lexx-polarnet-pl/planck6502/Mechanical/README.md

## Planck/Lexx W65C02 Computer – Mechanical Parts

This folder contains 3D models and printable components designed for assembling the Planck/Lexx W65C02 computer.
