lexx-polarnet-pl/planck6502/Hardware/joystick_board/README.md

## Planck 6502 Joystick Interface

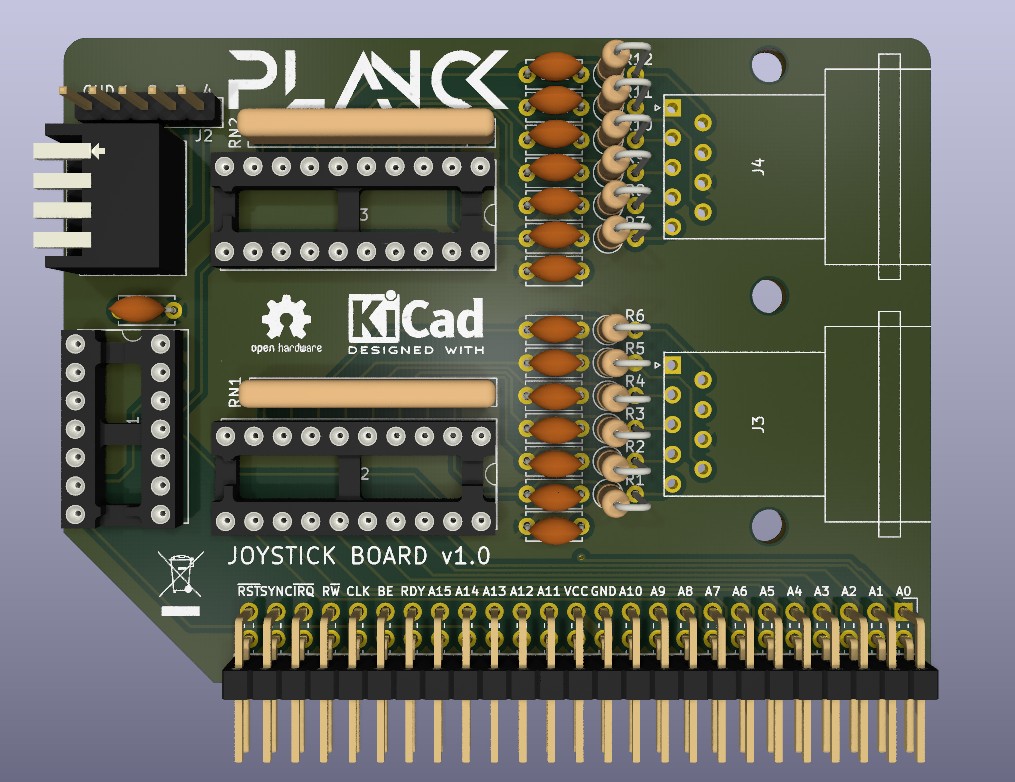
[picture p3: Hardware/joystick_board/pictures/joystick_prototype_render.jpg]
Joystick Board prototype 3D render


This is the dual joystick interface card for the Planck 6502 computer.

This is an entirely new build, not based on any existing board from the original Planck project.

## Revision History

| Version | Status | Changes |
| :---: | :---: | :--- |
| **1.0** | Under construction | Initial design |

**This board is a work in progress.**

This card aims to be a simple interface between joysticks and the 6502 CPU. The design supports standard Atari DB9 joysticks, extended to support dual fire buttons. The card also features built-in ESD protection.
