lexx-polarnet-pl/planck6502/Hardware/keyboard_mouse_board/1.1/board.png

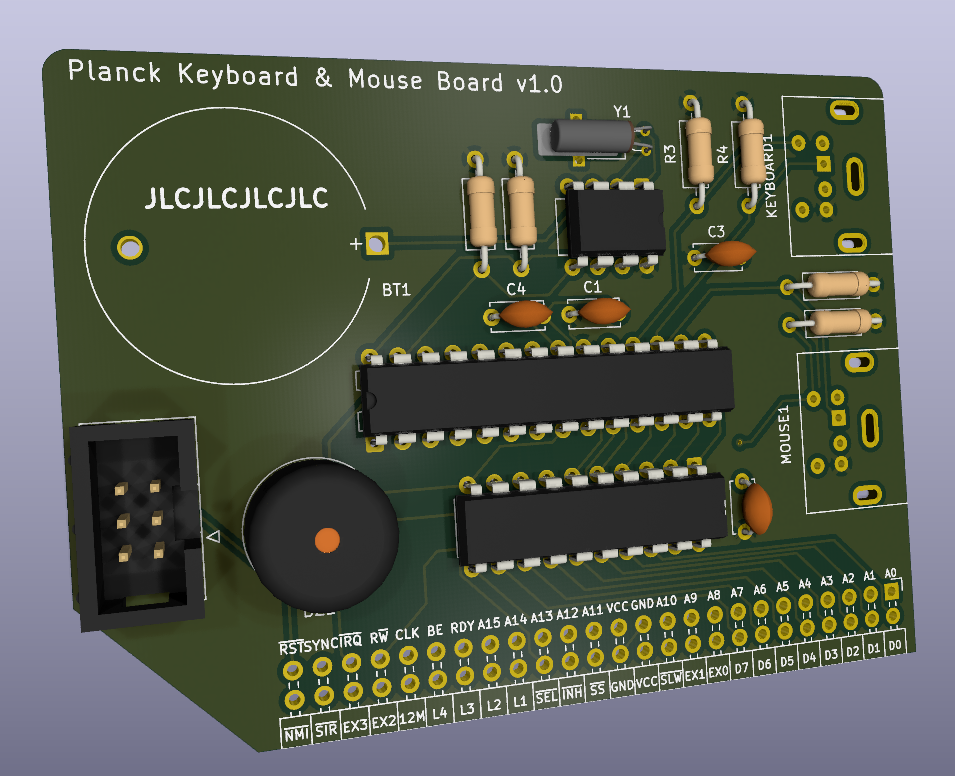
Hardware/keyboard_mouse_board/1.1/board.png
