lexx-polarnet-pl/planck6502/Hardware/keyboard_mouse_board/pictures/keyboard_mouse_board_1.0_back.jpg

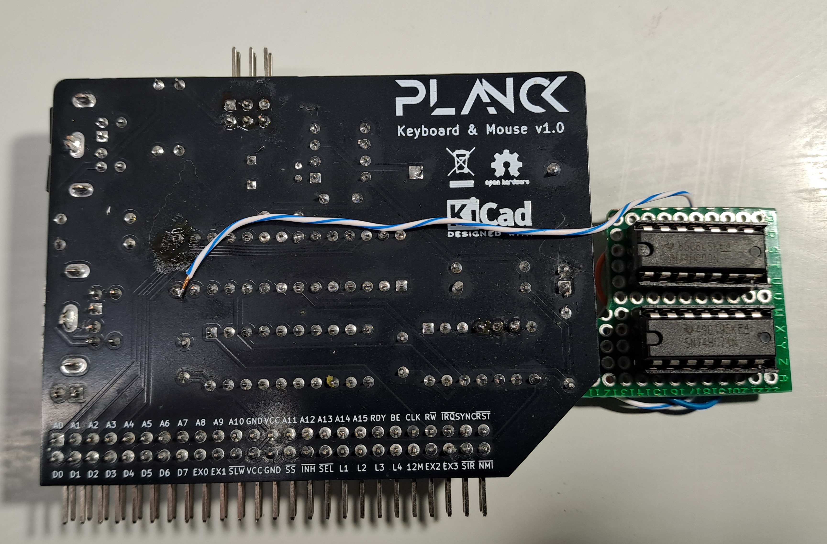
Hardware/keyboard_mouse_board/pictures/keyboard_mouse_board_1.0_back.jpg
