lexx-polarnet-pl/planck6502/Hardware/mainboard/3D/barrel_jack.step

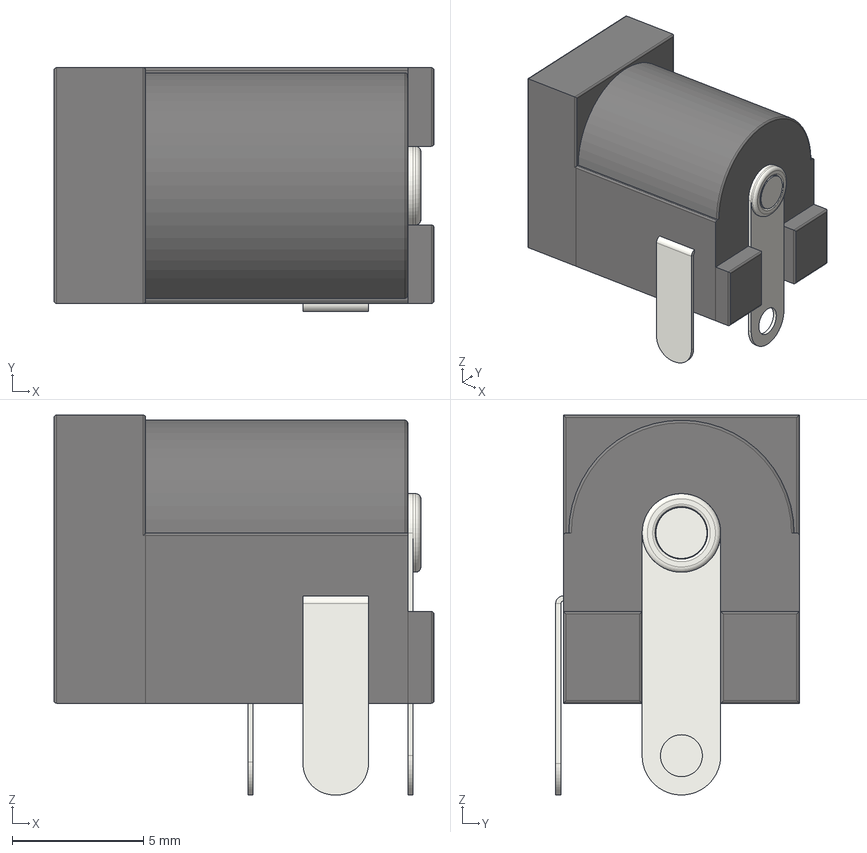
[picture p12: CAD file, 2026-10-25]
Hardware/mainboard/3D/barrel_jack.step
14.5 x 9.30 x 14.5 mm
