lexx-polarnet-pl/planck6502/Mechanical/planck_joystick_port_bracket.stl

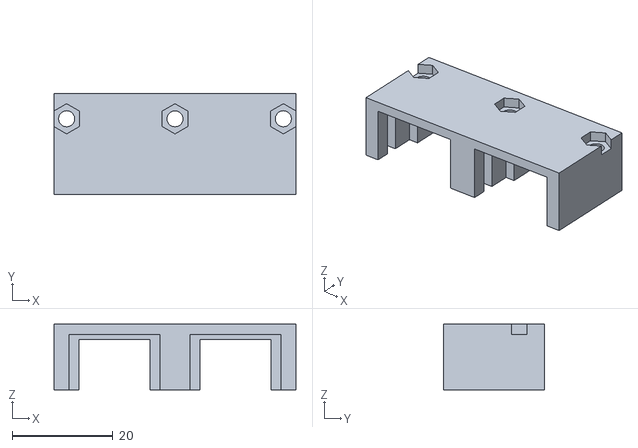
[picture p13: CAD file, 2026-11-07]
Mechanical/planck_joystick_port_bracket.stl
48.0 x 20.0 x 13.0
