lexx-polarnet-pl/planck6502/Mechanical/cards_separator.stl

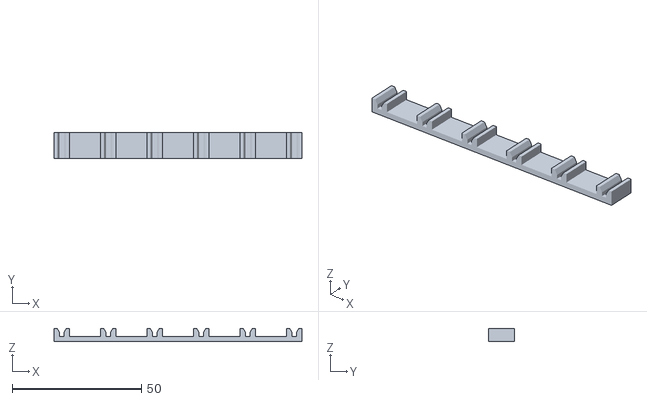
[picture p14: CAD file, 2026-10-25]
Mechanical/cards_separator.stl
96.0 x 10.0 x 5.00
