lexx-polarnet-pl/planck6502/Hardware/joystick_board/joystick.kicad_pcb

## KiCad design Hardware/joystick_board/joystick.kicad_pcb (2026-11-11)

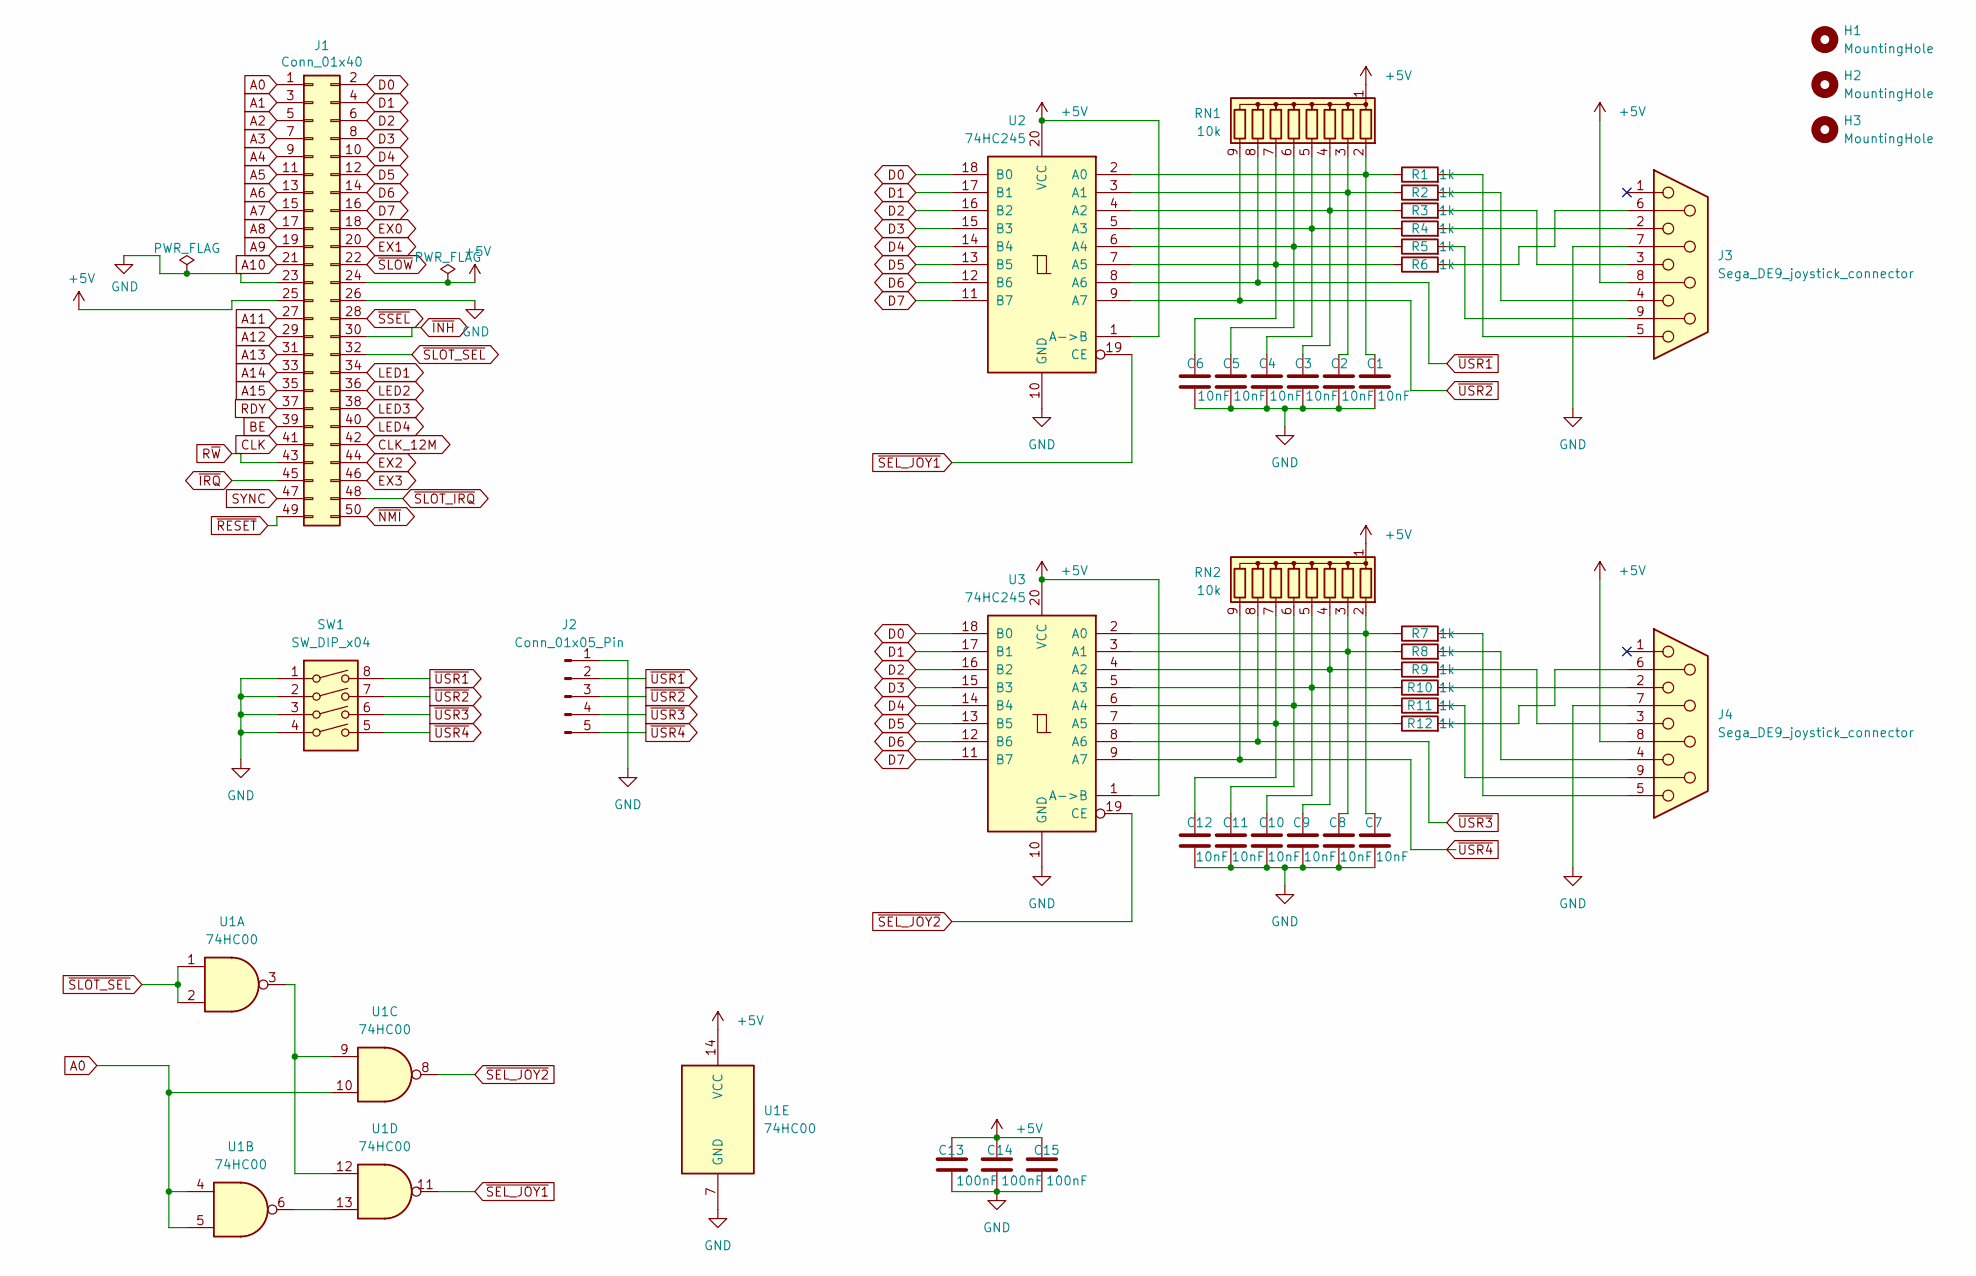
[picture p15: schematic joystick.kicad_sch, Planck joystick board]

Parts:
C1, C2, C3, C4, C5, C6, C7, C8, C9, C10, C11, C12: 10nF; C_Disc_D5.0mm_W2.5mm_P5.00mm
C13, C14, C15: 100nF; C_Disc_D5.0mm_W2.5mm_P5.00mm
H1, H2, H3: MountingHole; MountingHole_3.2mm_M3
J1: Conn_01x40; PinHeader_2x25_P2.54mm_Horizontal
J2: Conn_01x05_Pin; PinHeader_1x05_P2.54mm_Vertical
J3, J4: Sega_DE9_joystick_connector; Sega DE9 joystick connector
R1, R2, R3, R4, R5, R6, R7, R8, R9, R10, R11, R12: 1k; R_Axial_DIN0207_L6.3mm_D2.5mm_P2.54mm_Vertical
RN1, RN2: 10k; R_Array_SIP9
SW1: SW_DIP_x04; SW_DIP_SPSTx04_Piano_CTS_Series194-4MSTN_W7.62mm_P2.54mm
U1: 74HC00; DIP-14_W7.62mm_Socket
U2, U3: 74HC245; DIP-20_W7.62mm_Socket

Connections:
+5V: C13.1, C14.1, C15.1, J1.24, J1.25, J3.8, J4.8, RN1.1 (common), RN2.1 (common), U1.14 (VCC), U2.1 (A->B), U2.20 (VCC), U3.1 (A->B), U3.20 (VCC)
A0: J1.1, U1.4, U1.5, U1.10
A1: J1.3
A2: J1.5
A3: J1.7
A4: J1.9
A5: J1.11
A6: J1.13
A7: J1.15
A8: J1.17
A9: J1.19
A10: J1.21
A11: J1.27
A12: J1.29
A13: J1.31
A14: J1.33
A15: J1.35
BE: J1.39
CLK: J1.41
CLK_12M: J1.42
D0: J1.2, U2.18 (B0), U3.18 (B0)
D1: J1.4, U2.17 (B1), U3.17 (B1)
D2: J1.6, U2.16 (B2), U3.16 (B2)
D3: J1.8, U2.15 (B3), U3.15 (B3)
D4: J1.10, U2.14 (B4), U3.14 (B4)
D5: J1.12, U2.13 (B5), U3.13 (B5)
D6: J1.14, U2.12 (B6), U3.12 (B6)
D7: J1.16, U2.11 (B7), U3.11 (B7)
EX0: J1.18
EX1: J1.20
EX2: J1.44
EX3: J1.46
GND: C1.2, C2.2, C3.2, C4.2, C5.2, C6.2, C7.2, C8.2, C9.2, C10.2, C11.2, C12.2, C13.2, C14.2, C15.2, J1.23, J1.26, J2.1, J3.7, J4.7, SW1.1, SW1.2, SW1.3, SW1.4, U1.7 (GND), U2.10 (GND), U3.10 (GND)
LED1: J1.34
LED2: J1.36
LED3: J1.38
LED4: J1.40
unnamed: J3.2, R4.2
unnamed: J3.3, R3.2
unnamed: J3.4, R2.2
unnamed: J3.5, R1.2
unnamed: J3.6, R6.2
unnamed: J3.9, R5.2
unnamed: J4.2, R10.2
unnamed: J4.3, R9.2
unnamed: J4.4, R8.2
unnamed: J4.5, R7.2
unnamed: J4.6, R12.2
unnamed: J4.9, R11.2
unnamed: C1.1, R1.1, RN1.2 (R1), U2.2 (A0)
unnamed: C2.1, R2.1, RN1.3 (R2), U2.3 (A1)
unnamed: C3.1, R3.1, RN1.4 (R3), U2.4 (A2)
unnamed: C4.1, R4.1, RN1.5 (R4), U2.5 (A3)
unnamed: C5.1, R5.1, RN1.6 (R5), U2.6 (A4)
unnamed: C6.1, R6.1, RN1.7 (R6), U2.7 (A5)
unnamed: C7.1, R7.1, RN2.2 (R1), U3.2 (A0)
unnamed: C8.1, R8.1, RN2.3 (R2), U3.3 (A1)
unnamed: C9.1, R9.1, RN2.4 (R3), U3.4 (A2)
unnamed: C10.1, R10.1, RN2.5 (R4), U3.5 (A3)
unnamed: C11.1, R11.1, RN2.6 (R5), U3.6 (A4)
unnamed: C12.1, R12.1, RN2.7 (R6), U3.7 (A5)
unnamed: U1.3, U1.9, U1.12
unnamed: U1.6, U1.13
RDY: J1.37
R~W: J1.43
SYNC: J1.47
~INH: J1.30
~IRQ: J1.45
~NMI: J1.50
~RESET: J1.49
~SEL_JOY1: U1.11, U2.19 (CE)
~SEL_JOY2: U1.8, U3.19 (CE)
~SLOT_IRQ: J1.48
~SLOT_SEL: J1.32, U1.1, U1.2
~SLOW: J1.22
~SSEL: J1.28
~USR1: J2.2, RN1.8 (R7), SW1.8, U2.8 (A6)
~USR2: J2.3, RN1.9 (R8), SW1.7, U2.9 (A7)
~USR3: J2.4, RN2.8 (R7), SW1.6, U3.8 (A6)
~USR4: J2.5, RN2.9 (R8), SW1.5, U3.9 (A7)

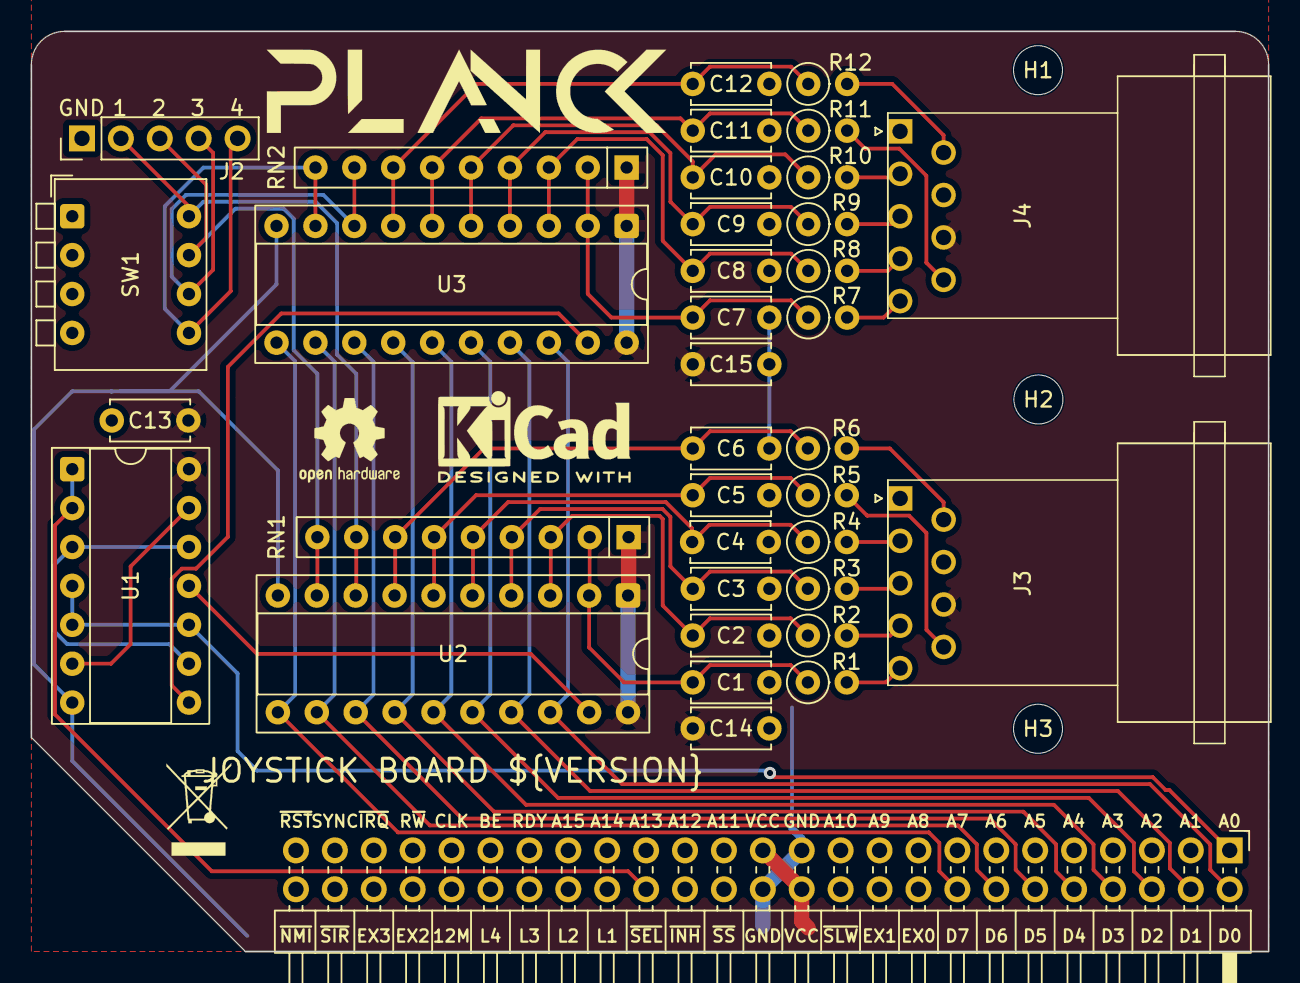
[picture p16: board joystick.kicad_pcb from above]

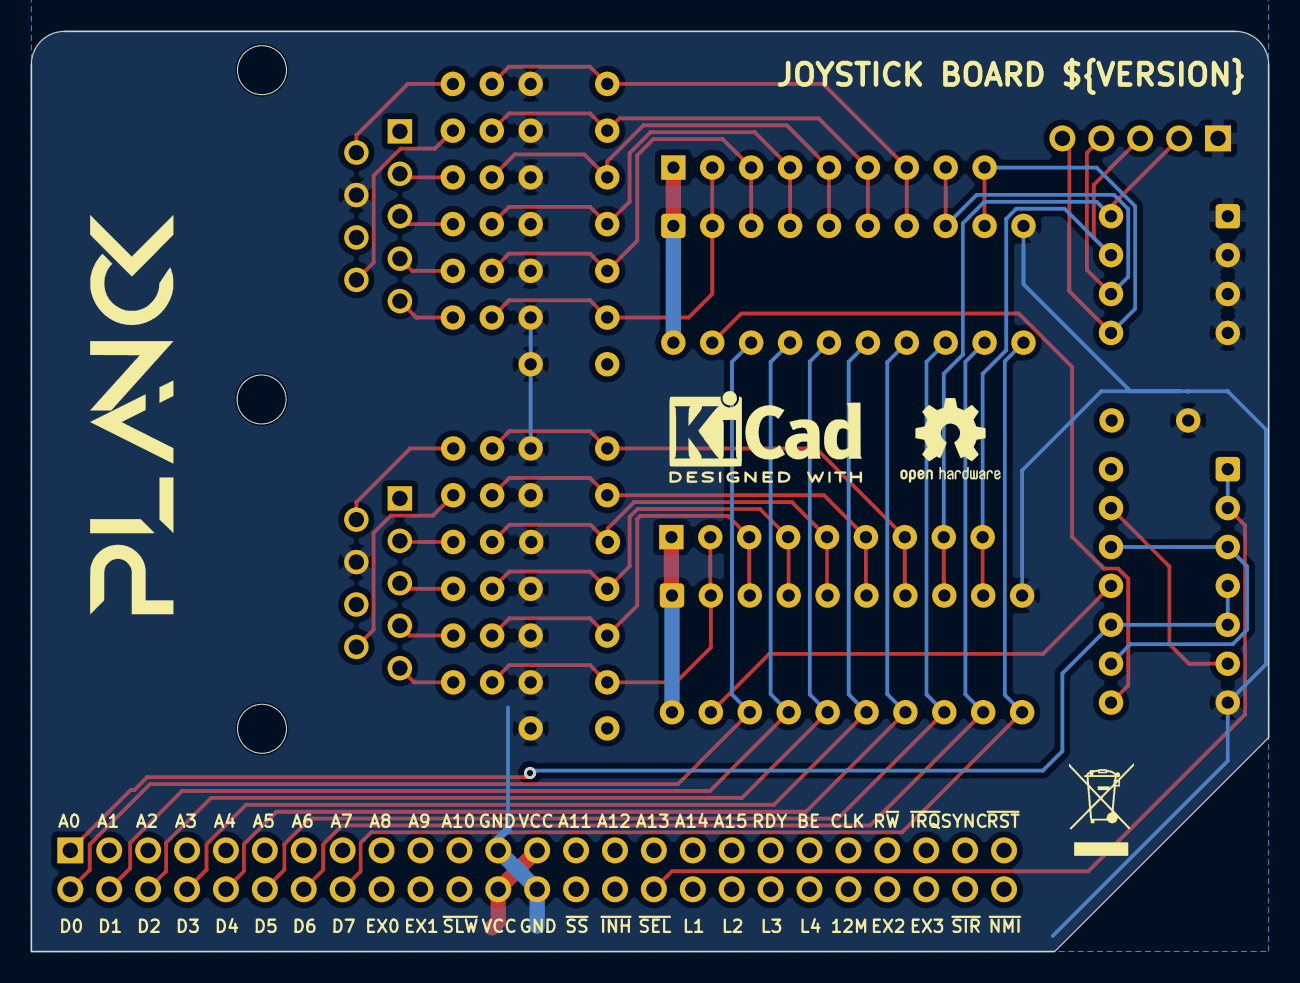
[picture p17: board joystick.kicad_pcb from below]

Board: 2 copper layers, 80.8 x 60.1 mm, 48 parts (4 on the bottom side), 44 nets.

Other parts of the board:
KICADLOGO1, KICADLOGO2: KiCad-Logo2_5mm_SilkScreen
LOGO1, LOGO2: LOGO; logo
OPENHARDWARE1, OPENHARDWARE2: OSHW-Logo2_7.3x6mm_SilkScreen
WASTE1, WASTE2: WEEE-Logo_4.2x6mm_SilkScreen
