lexx-polarnet-pl/planck6502/Hardware/pico_vga2/pico2_vga.kicad_pcb

## KiCad design Hardware/pico_vga2/pico2_vga.kicad_pcb (2026-11-11)

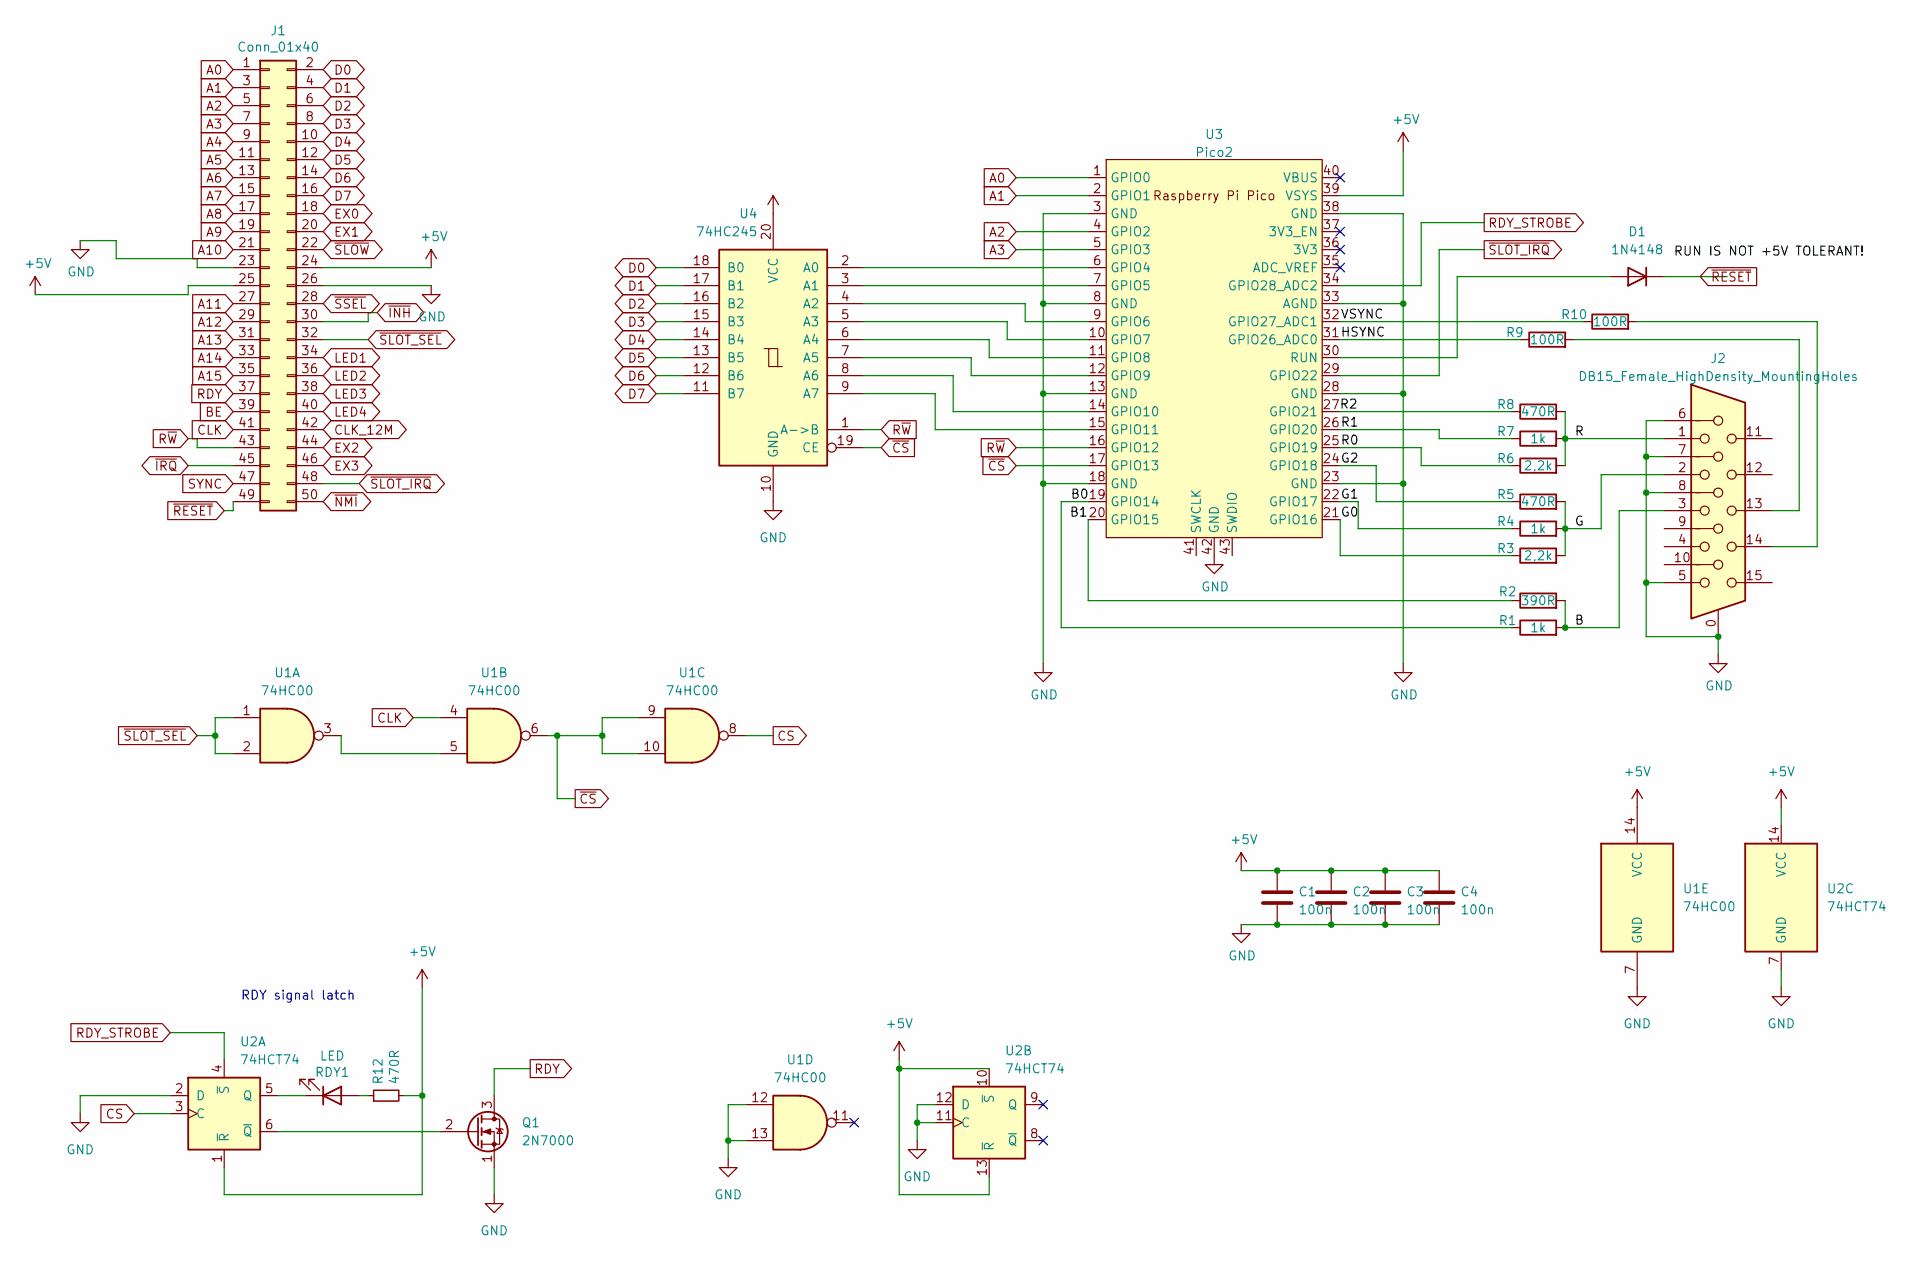
[picture p18: schematic pico2_vga.kicad_sch, Pico2 VGA board]

Parts:
C1, C2, C3, C4: 100n; C_Disc_D5.0mm_W2.5mm_P5.00mm
D1: 1N4148; D_DO-35_SOD27_P7.62mm_Horizontal
J1: Conn_01x40; PinHeader_2x25_P2.54mm_Horizontal
J2: DB15_Female_HighDensity_MountingHoles; DSUB-15-HD_Socket_Horizontal_P2.29x1.90mm_EdgePinOffset3.03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
Q1: 2N7000; TO-92_Inline
R1, R4, R7: 1k; R_Axial_DIN0309_L9.0mm_D3.2mm_P2.54mm_Vertical
R2: 390R; R_Axial_DIN0309_L9.0mm_D3.2mm_P2.54mm_Vertical
R3, R6: 2,2k; R_Axial_DIN0309_L9.0mm_D3.2mm_P2.54mm_Vertical
R5, R8: 470R; R_Axial_DIN0309_L9.0mm_D3.2mm_P2.54mm_Vertical
R9, R10: 100R; R_Axial_DIN0309_L9.0mm_D3.2mm_P2.54mm_Vertical
R12: 470R; R_Axial_DIN0207_L6.3mm_D2.5mm_P10.16mm_Horizontal
RDY1: LED; LED_D3.0mm
U1: 74HC00; DIP-14_W7.62mm_Socket
U2: 74HCT74; DIP-14_W7.62mm_Socket
U3: Pico2; RPi_Pico_SMD_TH
U4: 74HC245; DIP-20_W7.62mm_Socket

Connections:
+5V: C1.1, C2.1, C3.1, C4.1, J1.24, J1.25, R12.2, U1.14 (VCC), U2.1 (~R), U2.10 (~S), U2.13 (~R), U2.14 (VCC), U3.39 (VSYS), U4.20 (VCC)
/B: J2.3, R1.2, R2.2
/B0: R1.1, U3.19 (GPIO14)
/B1: R2.1, U3.20 (GPIO15)
/G: J2.2, R3.2, R4.2, R5.2
/G0: R3.1, U3.21 (GPIO16)
/G1: R4.1, U3.22 (GPIO17)
/G2: R5.1, U3.24 (GPIO18)
/HSYNC: R9.1, U3.31 (GPIO26_ADC0)
/R: J2.1, R6.2, R7.2, R8.2
/R0: R6.1, U3.25 (GPIO19)
/R1: R7.1, U3.26 (GPIO20)
/R2: R8.1, U3.27 (GPIO21)
/VSYNC: R10.1, U3.32 (GPIO27_ADC1)
A0: J1.1, U3.1 (GPIO0)
A1: J1.3, U3.2 (GPIO1)
A2: J1.5, U3.4 (GPIO2)
A3: J1.7, U3.5 (GPIO3)
A4: J1.9
A5: J1.11
A6: J1.13
A7: J1.15
A8: J1.17
A9: J1.19
A10: J1.21
A11: J1.27
A12: J1.29
A13: J1.31
A14: J1.33
A15: J1.35
BE: J1.39
CLK: J1.41, U1.4
CLK_12M: J1.42
CS: U1.8, U2.3 (C)
D0: J1.2, U4.18 (B0)
D1: J1.4, U4.17 (B1)
D2: J1.6, U4.16 (B2)
D3: J1.8, U4.15 (B3)
D4: J1.10, U4.14 (B4)
D5: J1.12, U4.13 (B5)
D6: J1.14, U4.12 (B6)
D7: J1.16, U4.11 (B7)
EX0: J1.18
EX1: J1.20
EX2: J1.44
EX3: J1.46
GND: C1.2, C2.2, C3.2, C4.2, J1.23, J1.26, J2.0, J2.5, J2.6, J2.7, J2.8, Q1.1 (S), U1.7 (GND), U1.12, U1.13, U2.2 (D), U2.7 (GND), U2.11 (C), U2.12 (D), U3.3 (GND), U3.8 (GND), U3.13 (GND), U3.18 (GND), U3.23 (GND), U3.28 (GND), U3.33 (AGND), U3.38 (GND), U3.42 (GND), U4.10 (GND)
LED1: J1.34
LED2: J1.36
LED3: J1.38
LED4: J1.40
unnamed: D1.2 (A), U3.30 (RUN)
unnamed: J2.13, R9.2
unnamed: J2.14, R10.2
unnamed: Q1.2 (G), U2.6 (~Q)
unnamed: R12.1, RDY1.2 (A)
unnamed: RDY1.1 (K), U2.5 (Q)
unnamed: U1.3, U1.5
unnamed: U3.6 (GPIO4), U4.2 (A0)
unnamed: U3.7 (GPIO5), U4.3 (A1)
unnamed: U3.9 (GPIO6), U4.4 (A2)
unnamed: U3.10 (GPIO7), U4.5 (A3)
unnamed: U3.11 (GPIO8), U4.6 (A4)
unnamed: U3.12 (GPIO9), U4.7 (A5)
unnamed: U3.14 (GPIO10), U4.8 (A6)
unnamed: U3.15 (GPIO11), U4.9 (A7)
RDY: J1.37, Q1.3 (D)
RDY_STROBE: U2.4 (~S), U3.34 (GPIO28_ADC2)
R~W: J1.43, U3.16 (GPIO12), U4.1 (A->B)
SYNC: J1.47
~CS: U1.6, U1.9, U1.10, U3.17 (GPIO13), U4.19 (CE)
~INH: J1.30
~IRQ: J1.45
~NMI: J1.50
~RESET: D1.1 (K), J1.49
~SLOT_IRQ: J1.48, U3.29 (GPIO22)
~SLOT_SEL: J1.32, U1.1, U1.2
~SLOW: J1.22
~SSEL: J1.28

Notes on the sheet:
RDY signal latch

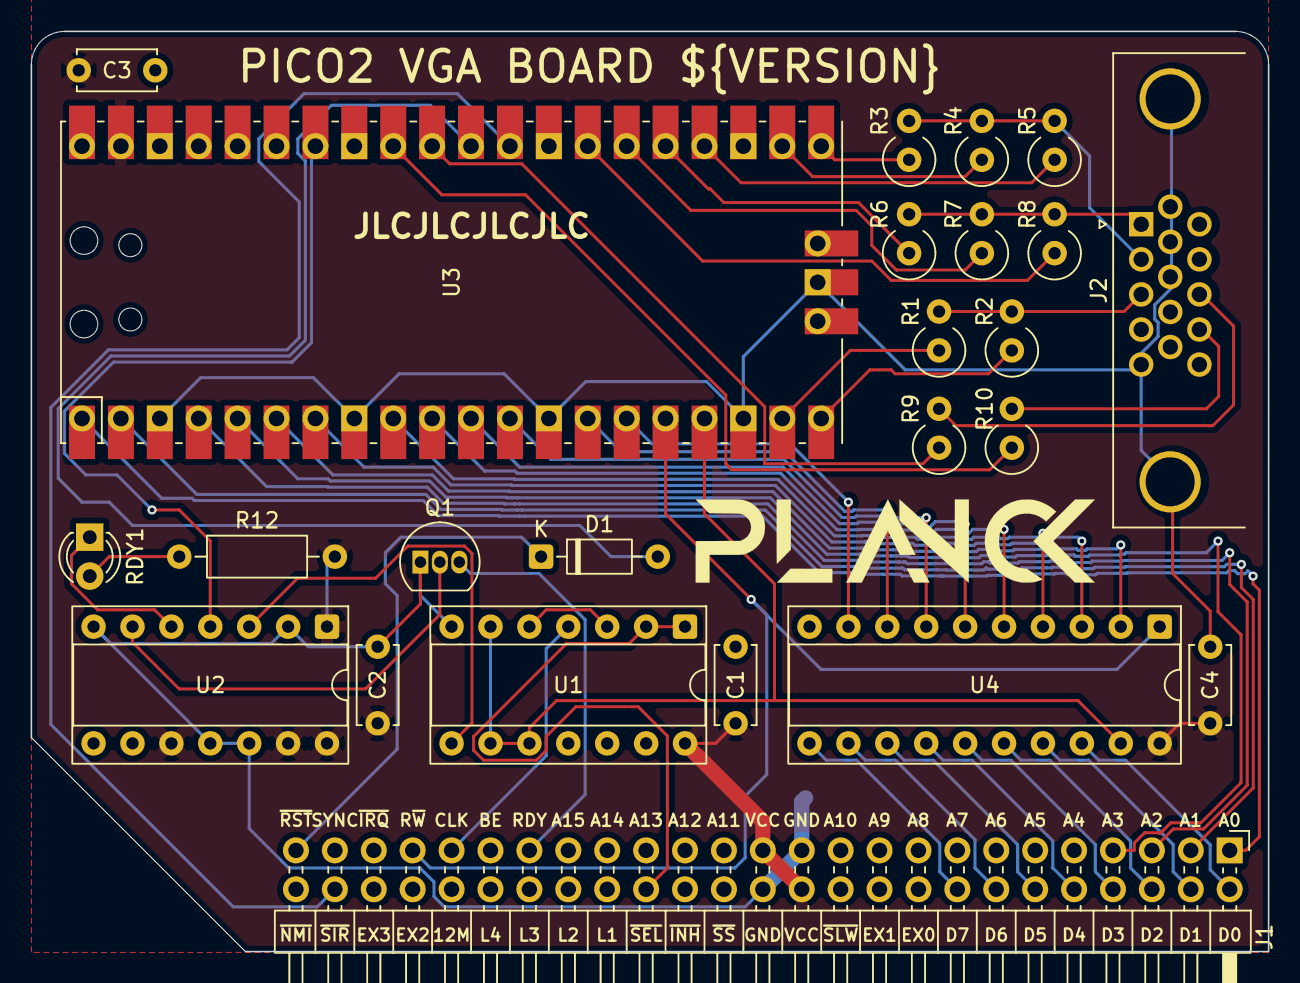
[picture p19: board pico2_vga.kicad_pcb from above]

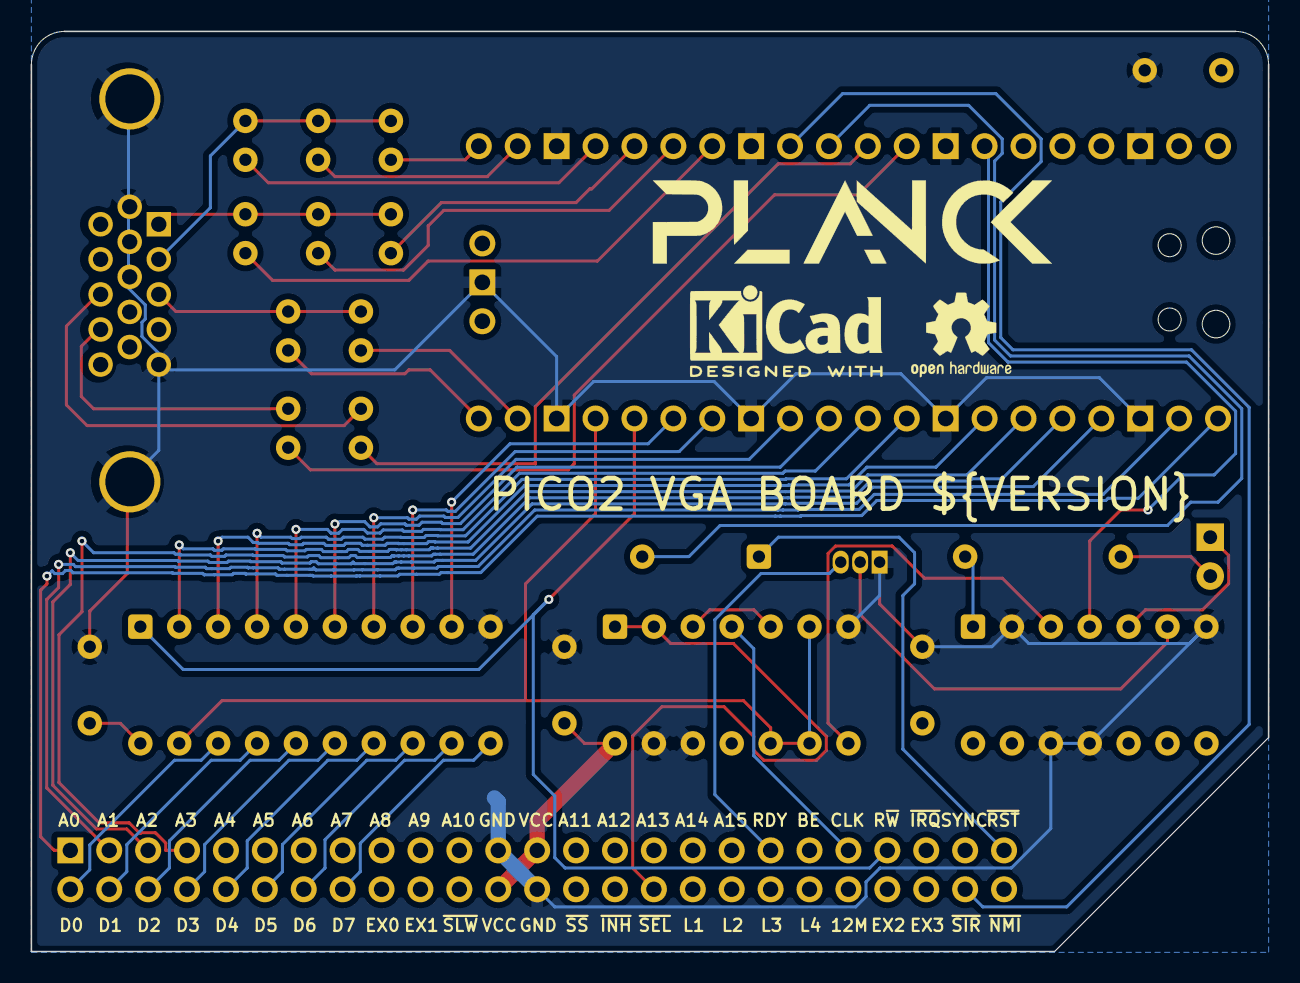
[picture p20: board pico2_vga.kicad_pcb from below]

Board: 2 copper layers, 80.8 x 60.1 mm, 28 parts (3 on the bottom side), 51 nets.

Other parts of the board:
KICAD1: KiCad-Logo2_5mm_SilkScreen
LOGO1, LOGO1#2: LOGO; logo
OSHW1: OSHW-Logo2_7.3x6mm_SilkScreen
