lexx-polarnet-pl/planck6502/Hardware/keyboard_mouse_board/1.2/kb_mouse.kicad_pcb

## KiCad design Hardware/keyboard_mouse_board/1.2/kb_mouse.kicad_pcb (2026-11-10)

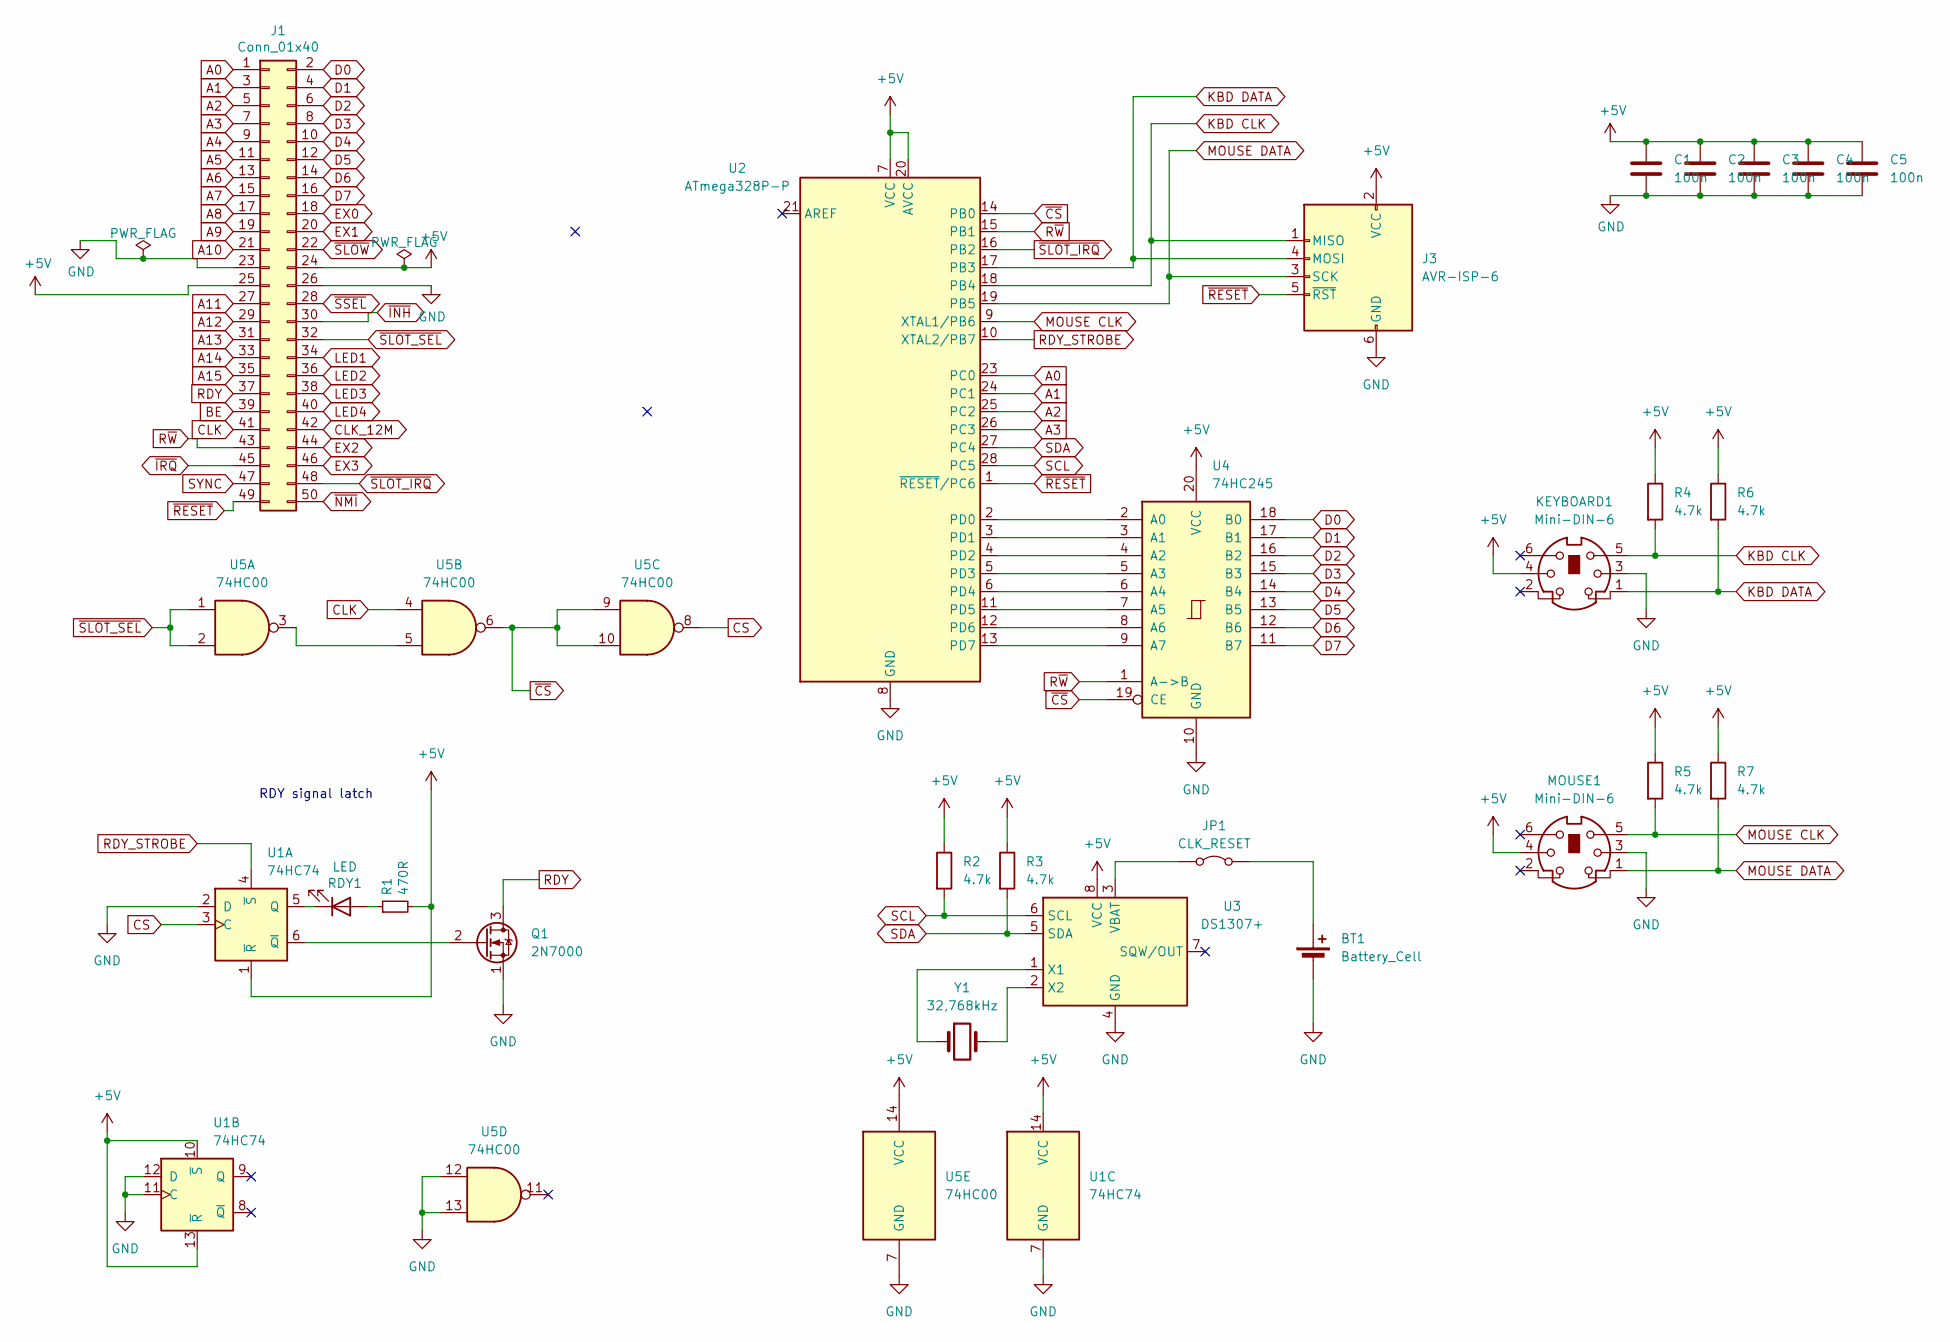
[picture p21: schematic kb_mouse.kicad_sch, Planck 6502 keyboard and mouse interface]

Parts:
BT1: Battery_Cell; BatteryHolder_MYOUNG_BS-07-A1BJ001_CR2032
C1, C2, C3, C4, C5: 100n; C_Disc_D5.0mm_W2.5mm_P5.00mm
J1: Conn_01x40; PinHeader_2x25_P2.54mm_Horizontal
J3: AVR-ISP-6; IDC-Header_2x03_P2.54mm_Horizontal
JP1: CLK_RESET; PinHeader_1x02_P2.54mm_Vertical
KEYBOARD1: Mini-DIN-6; Connector_Mini-DIN_Female_6Pin_2rows
MOUSE1: Mini-DIN-6; Connector_Mini-DIN_Female_6Pin_2rows
Q1: 2N7000; TO-92_Inline
R1: 470R; R_Axial_DIN0207_L6.3mm_D2.5mm_P10.16mm_Horizontal
R2, R3, R4, R5, R6, R7: 4.7k; R_Axial_DIN0207_L6.3mm_D2.5mm_P10.16mm_Horizontal
RDY1: LED; LED_D3.0mm
U1: 74HC74; DIP-14_W7.62mm_Socket
U2: ATmega328P-P; DIP-28_W7.62mm_Socket
U3: DS1307+; DIP-8_W7.62mm_Socket
U4: 74HC245; DIP-20_W7.62mm_Socket
U5: 74HC00; DIP-14_W7.62mm_Socket
Y1: 32,768kHz; Crystal_DS15_D1.5mm_L5.0mm_Horizontal_1EP_style2

Connections:
+5V: C1.1, C2.1, C3.1, C4.1, C5.1, J1.24, J1.25, J3.2 (VCC), KEYBOARD1.4, MOUSE1.4, R1.2, R2.1, R3.1, R4.1, R5.1, R6.1, R7.1, U1.1 (~R), U1.10 (~S), U1.13 (~R), U1.14 (VCC), U2.7 (VCC), U2.20 (AVCC), U3.8 (VCC), U4.20 (VCC), U5.14 (VCC); also elsewhere on the board
A0: J1.1, U2.23 (PC0)
A1: J1.3, U2.24 (PC1)
A2: J1.5, U2.25 (PC2)
A3: J1.7, U2.26 (PC3)
A4: J1.9
A5: J1.11
A6: J1.13
A7: J1.15
A8: J1.17
A9: J1.19
A10: J1.21
A11: J1.27
A12: J1.29
A13: J1.31
A14: J1.33
A15: J1.35
BE: J1.39
CLK: J1.41, U5.4
CLK_12M: J1.42
CS: U1.3 (C), U5.8
D0: J1.2, U4.18 (B0)
D1: J1.4, U4.17 (B1)
D2: J1.6, U4.16 (B2)
D3: J1.8, U4.15 (B3)
D4: J1.10, U4.14 (B4)
D5: J1.12, U4.13 (B5)
D6: J1.14, U4.12 (B6)
D7: J1.16, U4.11 (B7)
EX0: J1.18
EX1: J1.20
EX2: J1.44
EX3: J1.46
GND: BT1.2 (-), C1.2, C2.2, C3.2, C4.2, C5.2, J1.23, J1.26, J3.6 (GND), KEYBOARD1.3, MOUSE1.3, Q1.1 (S), U1.2 (D), U1.7 (GND), U1.11 (C), U1.12 (D), U2.8 (GND), U2.22 (GND), U3.4 (GND), U4.10 (GND), U5.7 (GND), U5.12, U5.13; also elsewhere on the board
KBD CLK: J3.1 (MISO), KEYBOARD1.5, R4.2, U2.18 (PB4); also elsewhere on the board
KBD DATA: J3.4 (MOSI), KEYBOARD1.1, R6.2, U2.17 (PB3); also elsewhere on the board
LED1: J1.34
LED2: J1.36
LED3: J1.38
LED4: J1.40
MOUSE CLK: MOUSE1.5, R5.2, U2.9 (XTAL1/PB6); also elsewhere on the board
MOUSE DATA: J3.3 (SCK), MOUSE1.1, R7.2, U2.19 (PB5); also elsewhere on the board
unnamed: BT1.1 (+), JP1.2 (B)
unnamed: JP1.1 (A), U3.3 (VBAT)
unnamed: Q1.2 (G), U1.6 (~Q)
unnamed: R1.1, RDY1.2 (A)
unnamed: RDY1.1 (K), U1.5 (Q)
unnamed: U2.2 (PD0), U4.2 (A0)
unnamed: U2.3 (PD1), U4.3 (A1)
unnamed: U2.4 (PD2), U4.4 (A2)
unnamed: U2.5 (PD3), U4.5 (A3)
unnamed: U2.6 (PD4), U4.6 (A4)
unnamed: U2.11 (PD5), U4.7 (A5)
unnamed: U2.12 (PD6), U4.8 (A6)
unnamed: U2.13 (PD7), U4.9 (A7)
unnamed: U3.1 (X1), Y1.1
unnamed: U3.2 (X2), Y1.2
unnamed: U5.3, U5.5
RDY: J1.37, Q1.3 (D)
RDY_STROBE: U1.4 (~S), U2.10 (XTAL2/PB7); also elsewhere on the board
R~W: J1.43, U2.15 (PB1), U4.1 (A->B)
SCL: R2.2, U2.28 (PC5), U3.6 (SCL)
SDA: R3.2, U2.27 (PC4), U3.5 (SDA)
SYNC: J1.47
~CS: U2.14 (PB0), U4.19 (CE), U5.6, U5.9, U5.10
~INH: J1.30
~IRQ: J1.45
~NMI: J1.50
~RESET: J1.49, J3.5 (~RST), U2.1 (~RESET/PC6)
~SLOT_IRQ: J1.48, U2.16 (PB2)
~SLOT_SEL: J1.32, U5.1, U5.2
~SLOW: J1.22
~SSEL: J1.28

Notes on the sheet:
RDY signal latch

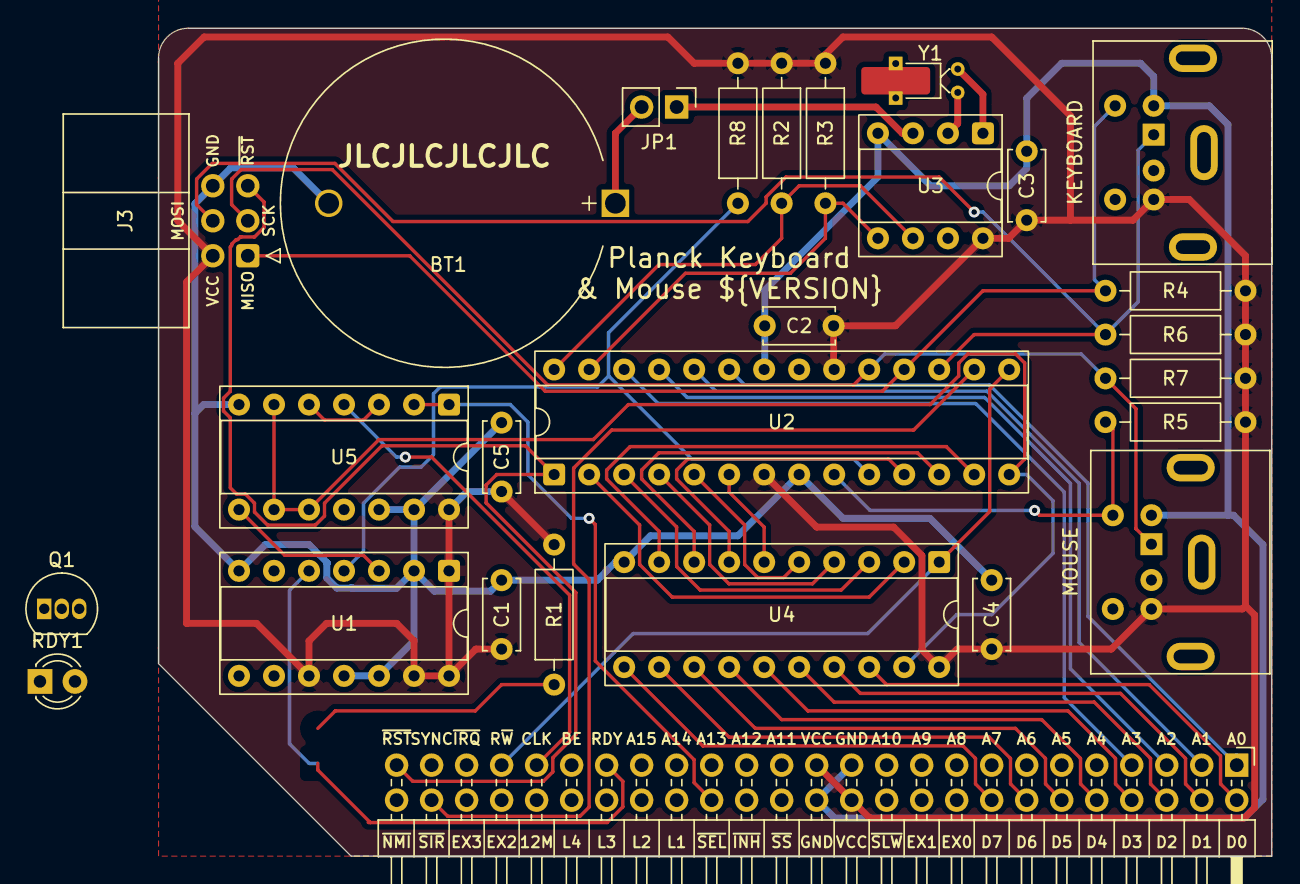
[picture p22: board kb_mouse.kicad_pcb from above]

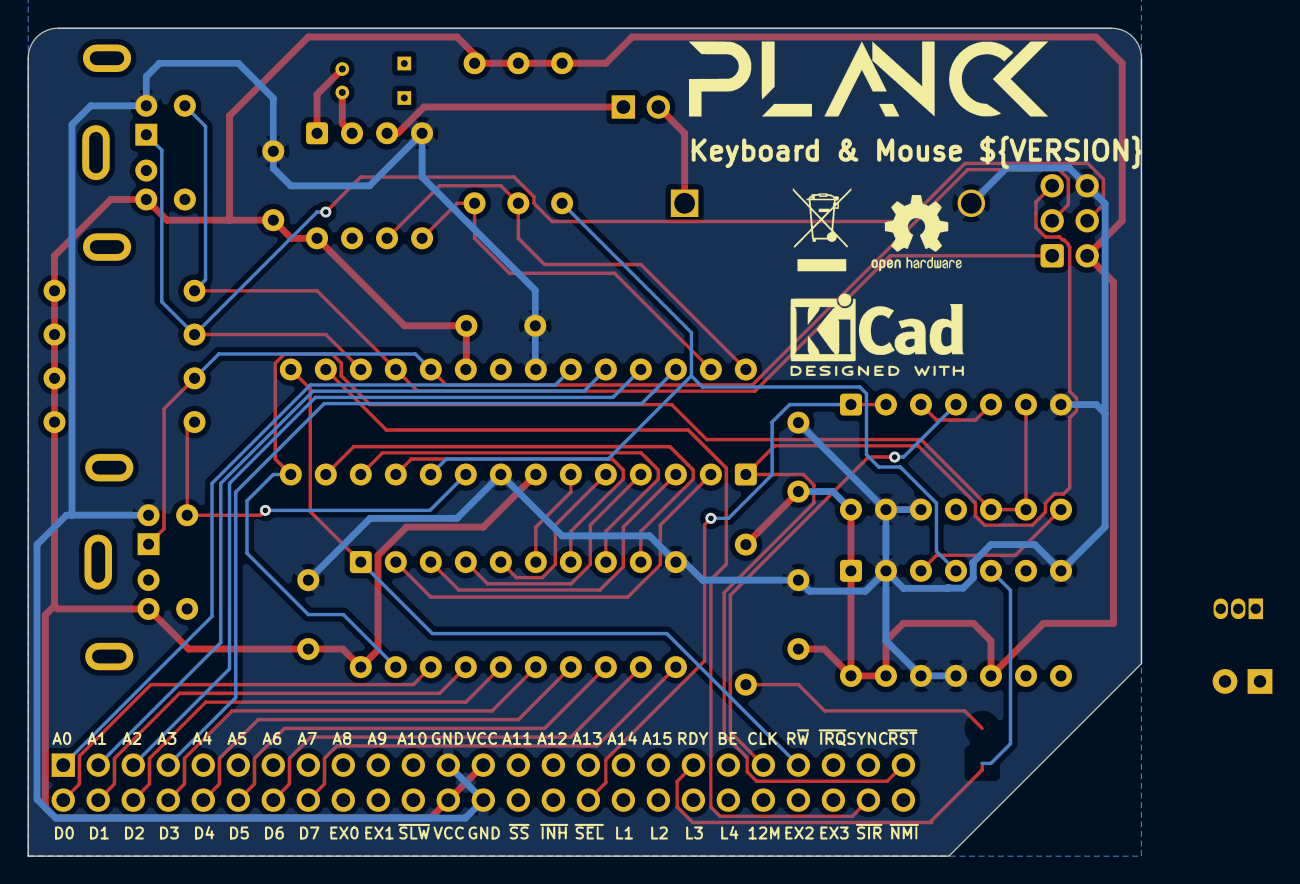
[picture p23: board kb_mouse.kicad_pcb from below]

Board: 2 copper layers, 80.8 x 60.1 mm, 31 parts (4 on the bottom side), 45 nets.

Other parts of the board:
KEYBOARD: Mini-DIN-6; Connector_Mini-DIN_Female_6Pin_2rows
KICADLOGO: KiCad-Logo2_5mm_SilkScreen
LOGO: LOGO; logo
MOUSE: Mini-DIN-6; Connector_Mini-DIN_Female_6Pin_2rows
OPENHARDWARE: OSHW-Logo2_7.3x6mm_SilkScreen
R8: 10k; R_Axial_DIN0207_L6.3mm_D2.5mm_P10.16mm_Horizontal
WASTE: WEEE-Logo_4.2x6mm_SilkScreen

Their connections:
+5V: KEYBOARD.4, MOUSE.4, R8.2; also elsewhere on the board
GND: KEYBOARD.3, MOUSE.3; also elsewhere on the board
KBD CLK: KEYBOARD.5; also elsewhere on the board
KBD DATA: KEYBOARD.1; also elsewhere on the board
MOUSE CLK: MOUSE.5; also elsewhere on the board
MOUSE DATA: MOUSE.1; also elsewhere on the board
RDY_STROBE: R8.1; also elsewhere on the board
