lexx-polarnet-pl/planck6502/Hardware/ram_board_AS6/1.1/ram_board.kicad_pcb

## KiCad design Hardware/ram_board_AS6/1.1/ram_board.kicad_pcb (2026-11-07)

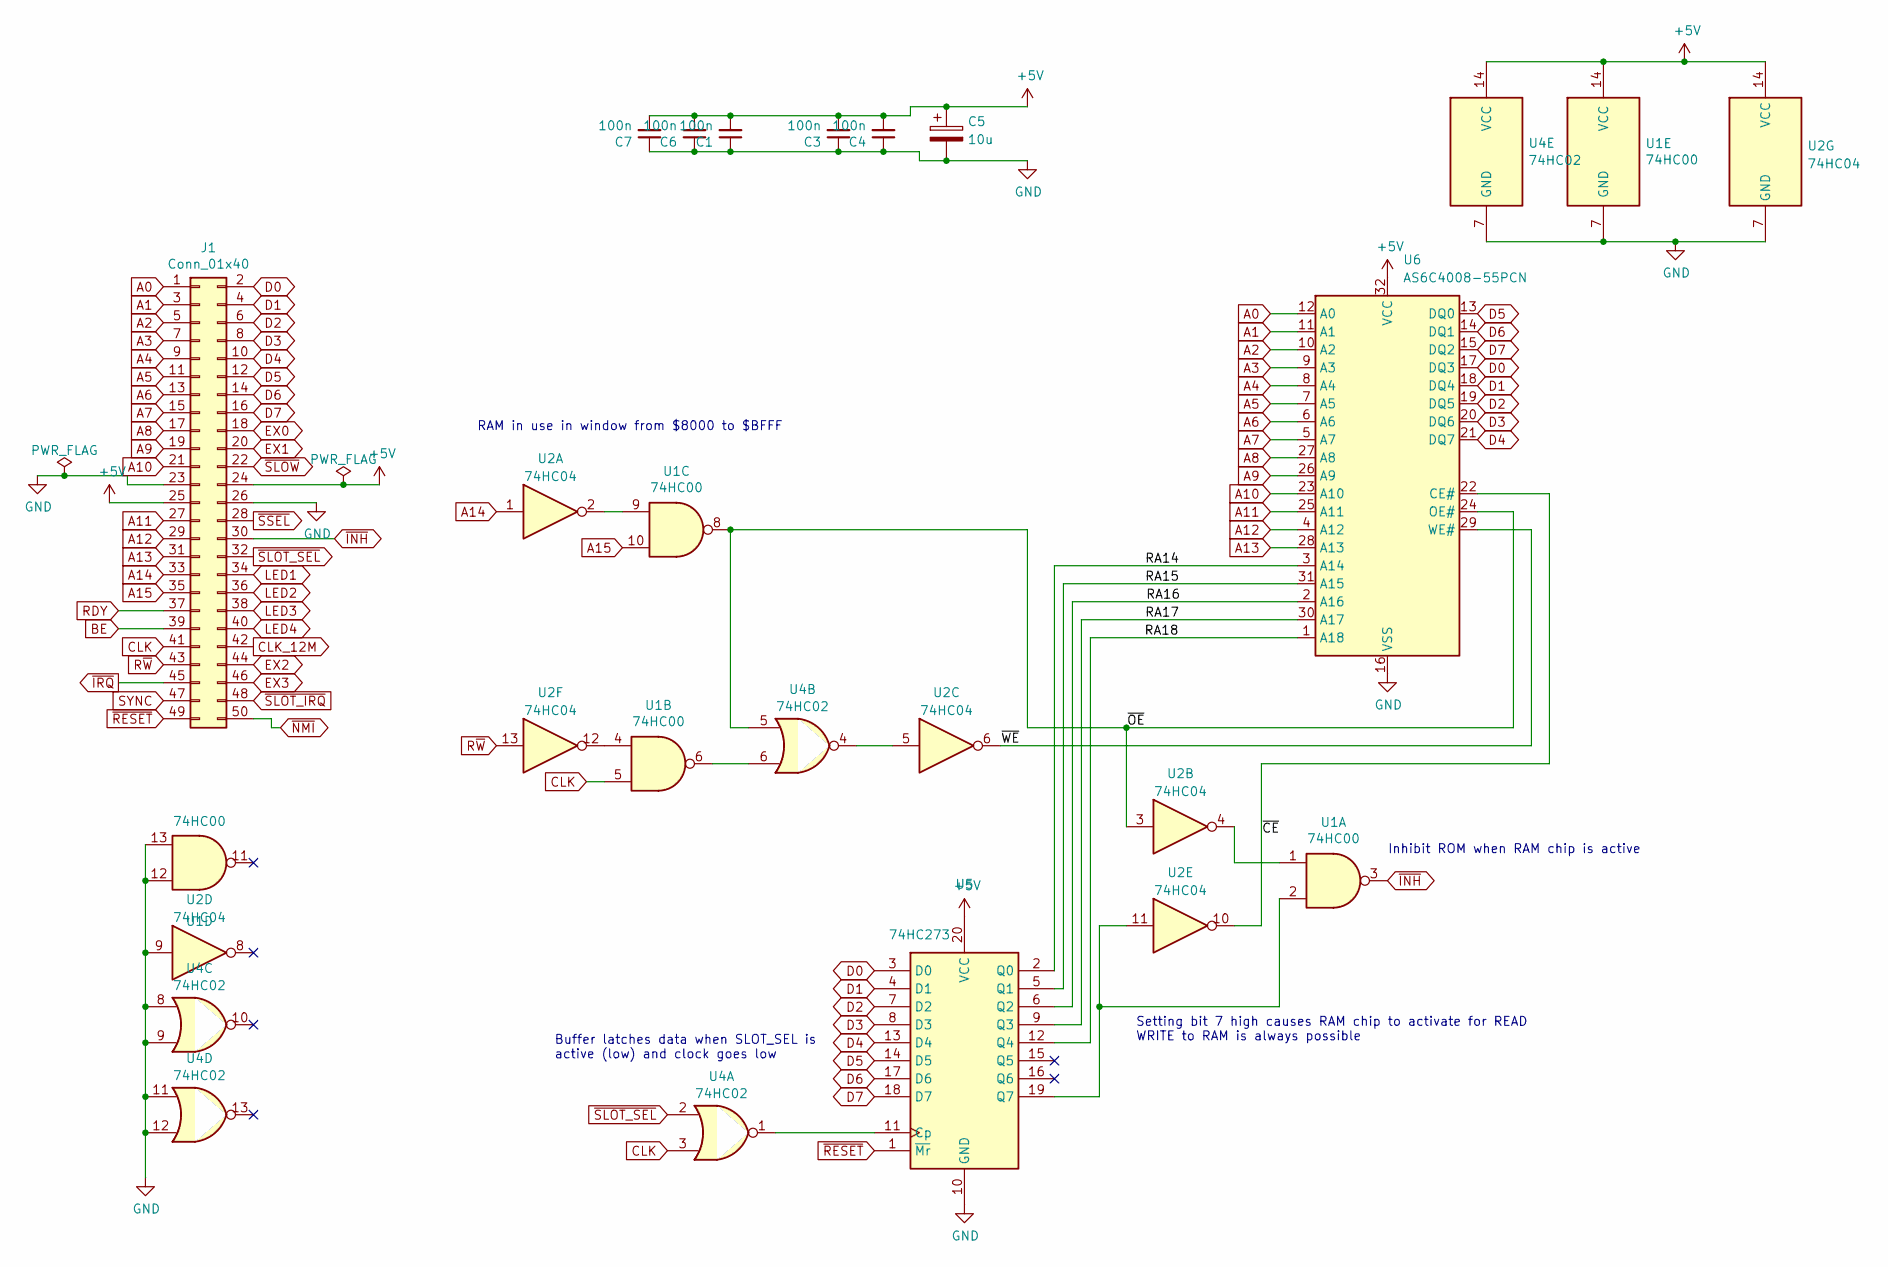
[picture p24: schematic ram_board.kicad_sch, AS6 RAM Board]

Parts:
C1, C3, C4, C6, C7: 100n; C_Disc_D4.3mm_W1.9mm_P5.00mm
C5: 10u; C_Radial_D5.0mm_H11.0mm_P2.00mm
J1: Conn_01x40; PinHeader_2x25_P2.54mm_Horizontal
U1: 74HC00; DIP-14_W7.62mm_Socket
U2: 74HC04; DIP-14_W7.62mm_Socket
U4: 74HC02; DIP-14_W7.62mm_Socket
U5: 74HC273; DIP-20_W7.62mm_Socket
U6: AS6C4008-55PCN; DIP-32_W15.24mm_Socket

Connections:
+5V: C1.2, C3.2, C4.2, C5.1, C6.2, C7.2, J1.24, J1.25, U1.14 (VCC), U2.14 (VCC), U4.14 (VCC), U5.20 (VCC), U6.32 (VCC)
/RA14: U5.2 (Q0), U6.3 (A14)
/RA15: U5.5 (Q1), U6.31 (A15)
/RA16: U5.6 (Q2), U6.2 (A16)
/RA17: U5.9 (Q3), U6.30 (A17)
/RA18: U5.12 (Q4), U6.1 (A18)
/~CE: U2.10, U6.22 (CE#)
/~OE: U1.8, U2.3, U4.5, U6.24 (OE#)
/~WE: U2.6, U6.29 (WE#)
A0: J1.1, U6.12 (A0)
A1: J1.3, U6.11 (A1)
A2: J1.5, U6.10 (A2)
A3: J1.7, U6.9 (A3)
A4: J1.9, U6.8 (A4)
A5: J1.11, U6.7 (A5)
A6: J1.13, U6.6 (A6)
A7: J1.15, U6.5 (A7)
A8: J1.17, U6.27 (A8)
A9: J1.19, U6.26 (A9)
A10: J1.21, U6.23 (A10)
A11: J1.27, U6.25 (A11)
A12: J1.29, U6.4 (A12)
A13: J1.31, U6.28 (A13)
A14: J1.33, U2.1
A15: J1.35, U1.10
BE: J1.39
CLK: J1.41, U1.5, U4.3
CLK_12M: J1.42
D0: J1.2, U5.3 (D0), U6.17 (DQ3)
D1: J1.4, U5.4 (D1), U6.18 (DQ4)
D2: J1.6, U5.7 (D2), U6.19 (DQ5)
D3: J1.8, U5.8 (D3), U6.20 (DQ6)
D4: J1.10, U5.13 (D4), U6.21 (DQ7)
D5: J1.12, U5.14 (D5), U6.13 (DQ0)
D6: J1.14, U5.17 (D6), U6.14 (DQ1)
D7: J1.16, U5.18 (D7), U6.15 (DQ2)
EX0: J1.18
EX1: J1.20
EX2: J1.44
EX3: J1.46
GND: C1.1, C3.1, C4.1, C5.2, C6.1, C7.1, J1.23, J1.26, U1.7 (GND), U1.12, U1.13, U2.7 (GND), U2.9, U4.7 (GND), U4.8, U4.9, U4.11, U4.12, U5.10 (GND), U6.16 (VSS)
LED1: J1.34
LED2: J1.36
LED3: J1.38
LED4: J1.40
unnamed: U1.1, U2.4
unnamed: U1.4, U2.12
unnamed: U1.6, U4.6
unnamed: U1.9, U2.2
unnamed: U2.5, U4.4
unnamed: U4.1, U5.11 (Cp)
unnamed: U1.2, U2.11, U5.19 (Q7)
RDY: J1.37
R~W: J1.43, U2.13
SYNC: J1.47
~INH: J1.30, U1.3
~IRQ: J1.45
~NMI: J1.50
~RESET: J1.49, U5.1 (~Mr)
~SLOT_IRQ: J1.48
~SLOT_SEL: J1.32, U4.2
~SLOW: J1.22
~SSEL: J1.28

Notes on the sheet:
Inhibit ROM when RAM chip is active
RAM in use in window from $8000 to $BFFF
Buffer latches data when SLOT_SEL is active (low) and clock goes low
Setting bit 7 high causes RAM chip to activate for READ WRITE to RAM is always possible

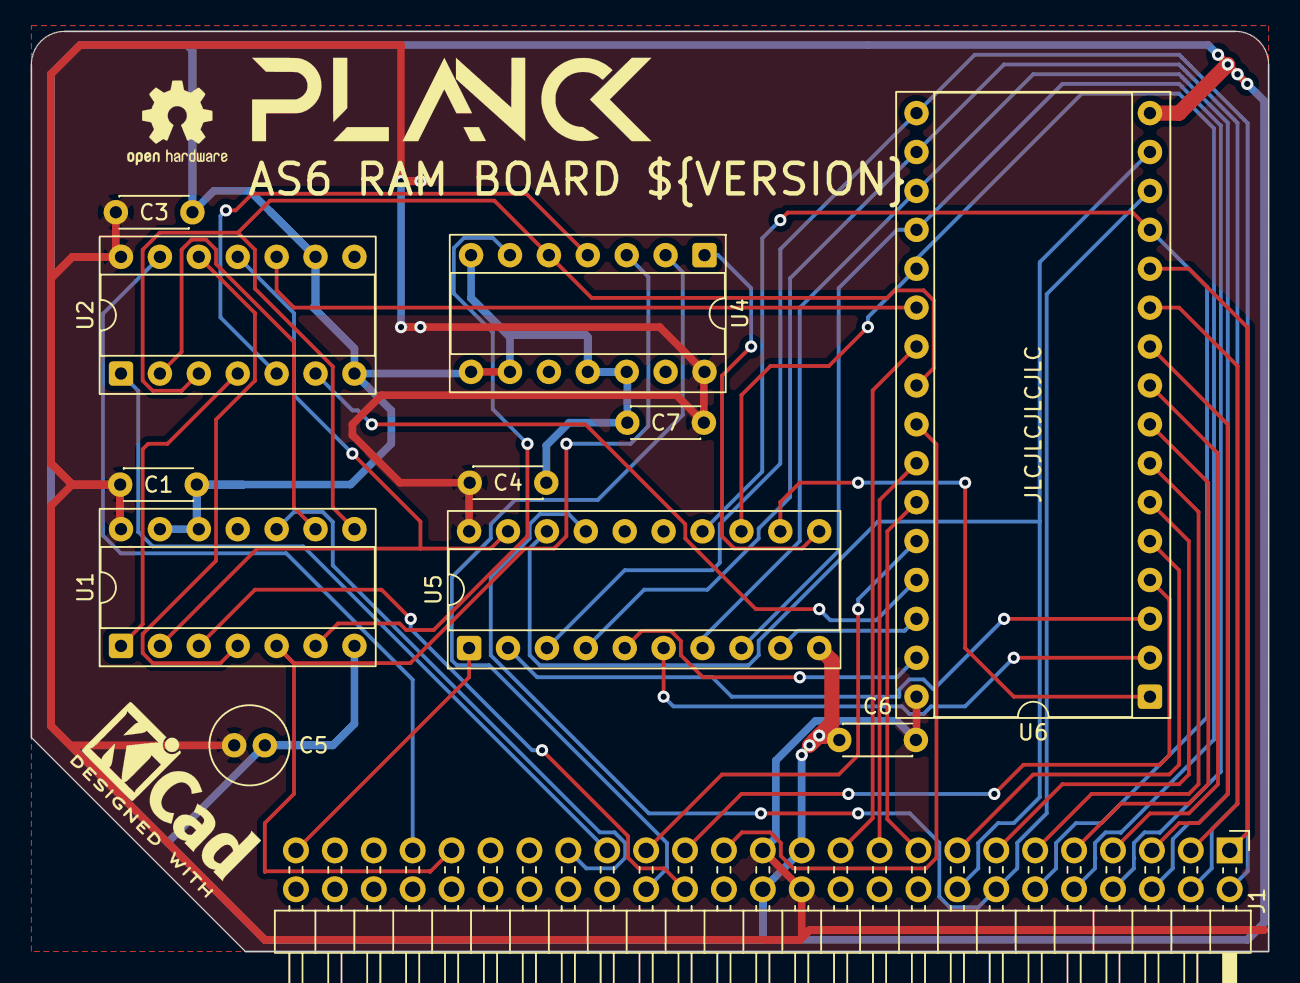
[picture p25: board ram_board.kicad_pcb from above]

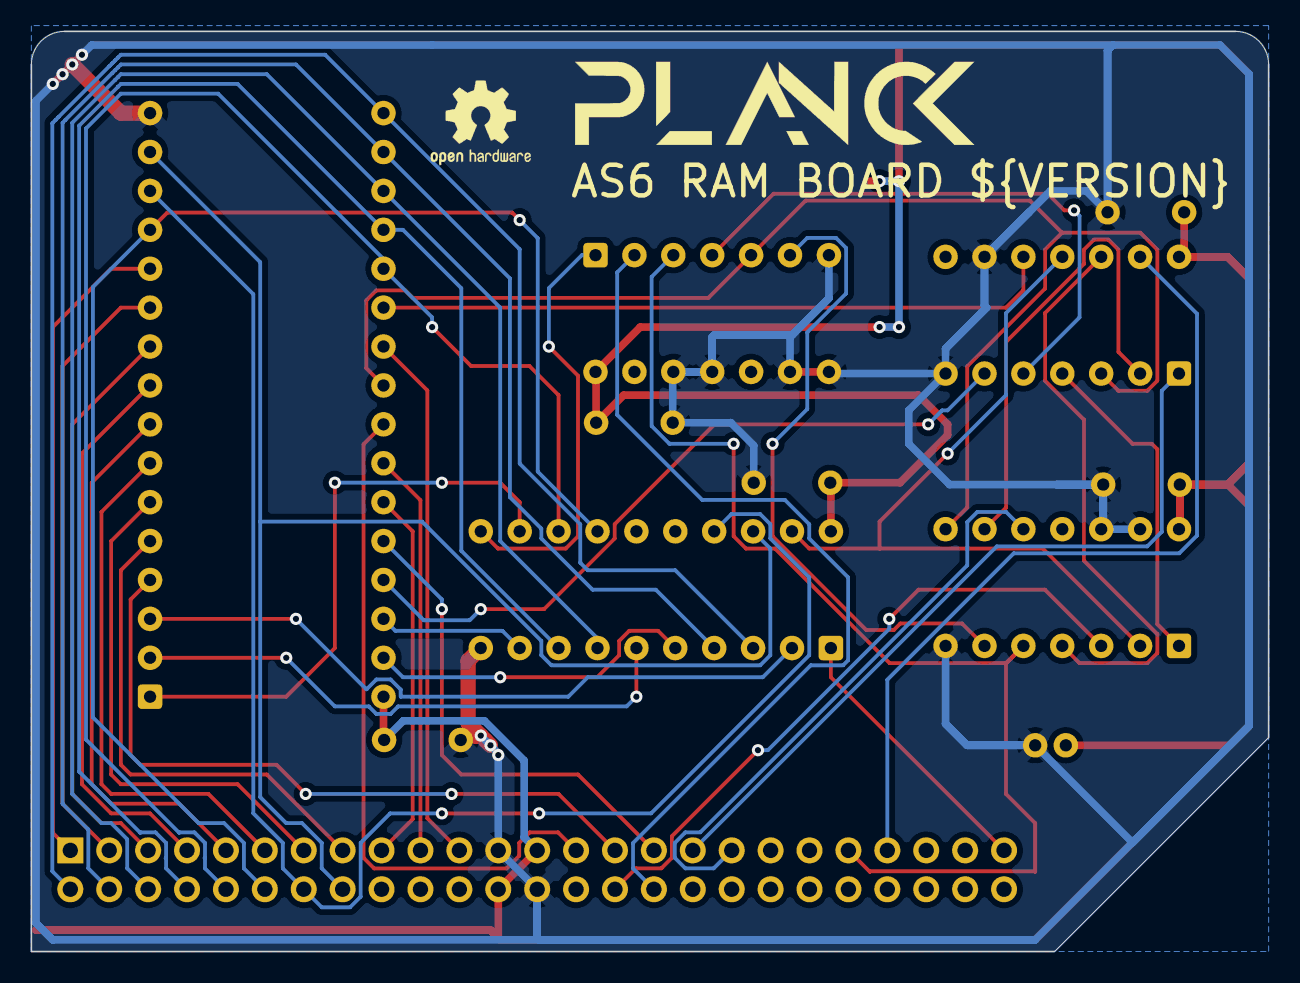
[picture p26: board ram_board.kicad_pcb from below]

Board: 2 copper layers, 80.8 x 60.1 mm, 16 parts (2 on the bottom side), 46 nets.

Other parts of the board:
LOGO, LOGO2: LOGO; logo
OSHW1, OSHW2: OSHW-Logo2_7.3x6mm_SilkScreen
