lexx-polarnet-pl/planck6502/Hardware/mainboard/mainboard.kicad_pcb

## KiCad design Hardware/mainboard/mainboard.kicad_pcb (2026-10-25)

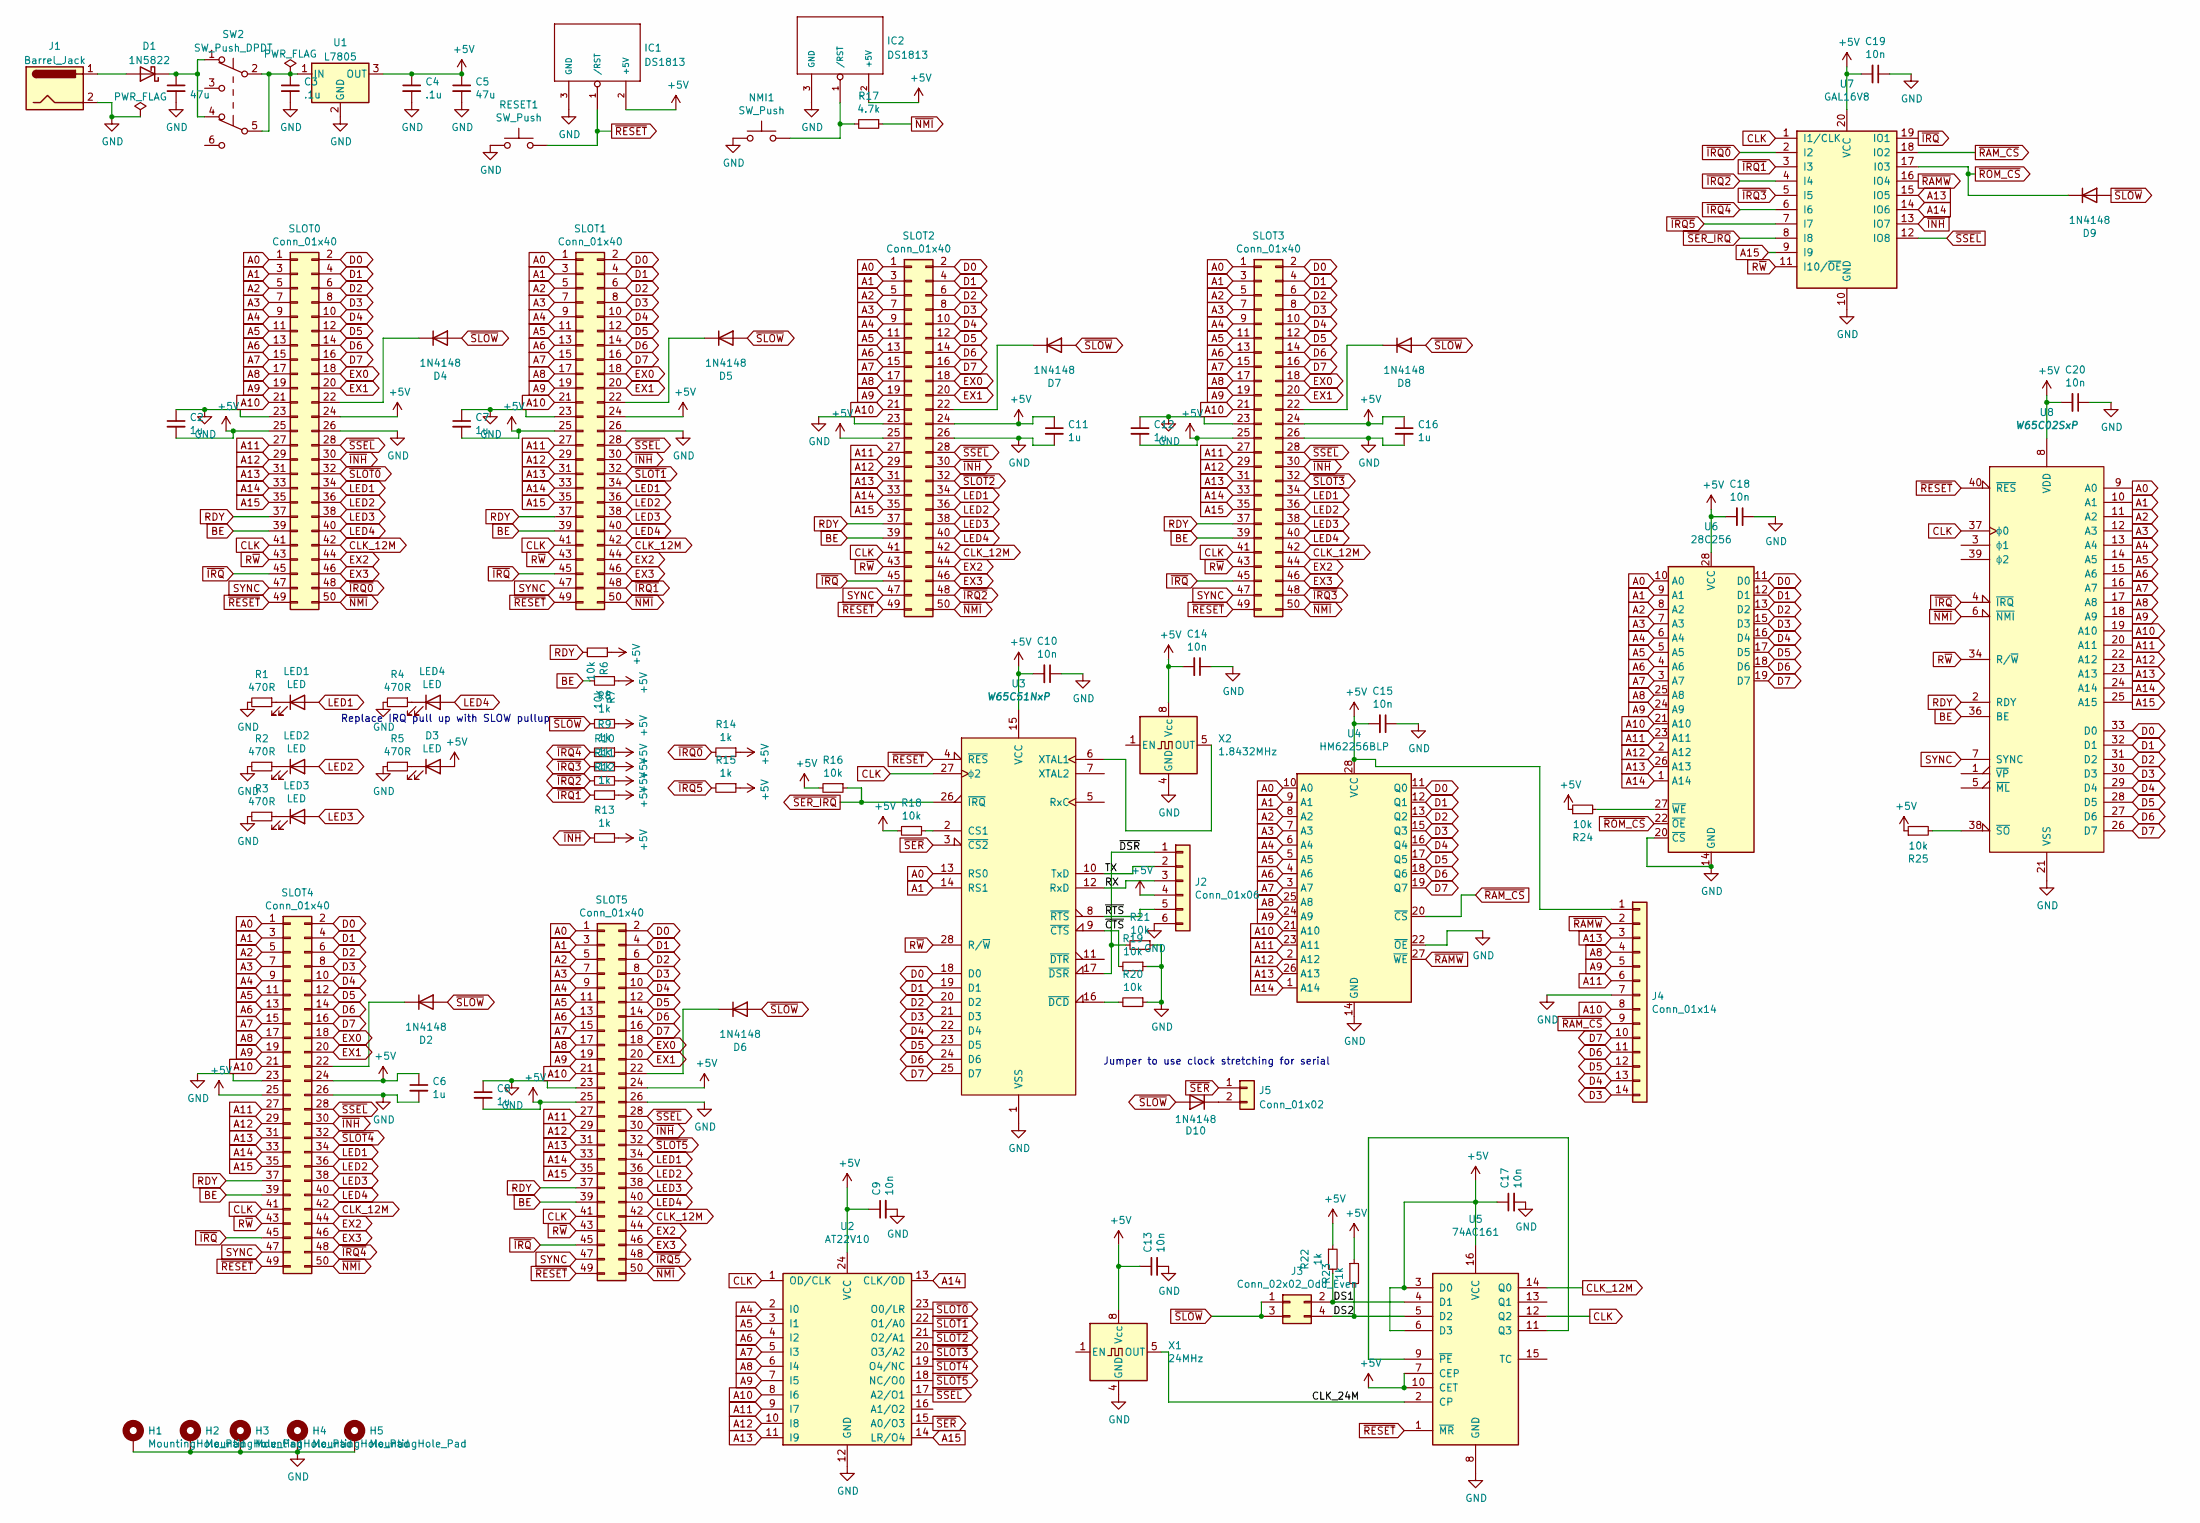
[picture p27: schematic mainboard.kicad_sch, Planck computer]

Parts:
C1, C5: 47u; CP_Radial_D4.0mm_P2.00mm
C2, C6, C7, C8, C11, C12, C16: 1u; C_Disc_D4.3mm_W1.9mm_P5.00mm
C3, C4: .1u; C_Disc_D4.3mm_W1.9mm_P5.00mm
C9, C10, C13, C14, C15, C17, C18, C19, C20: 10n; C_Disc_D4.3mm_W1.9mm_P5.00mm
D1: 1N5822; D_DO-201AD_P15.24mm_Horizontal
D2, D4, D5, D6, D7, D8, D9, D10: 1N4148; D_DO-35_SOD27_P7.62mm_Horizontal
D3: LED; LED_D3.0mm
H1, H2, H3, H4, H5: MountingHole_Pad; MountingHole_3.2mm_M3_Pad
IC1, IC2: DS1813; TO-92_Inline_Wide
J1: Barrel_Jack; BarrelJack_Horizontal
J2: Conn_01x06; PinSocket_1x06_P2.54mm_Vertical
J3: Conn_02x02_Odd_Even; PinHeader_2x02_P2.54mm_Vertical
J4: Conn_01x14; PinSocket_1x14_P2.54mm_Vertical
J5: Conn_01x02; PinHeader_1x02_P2.54mm_Vertical
LED1, LED2, LED3, LED4: LED; LED_D3.0mm
NMI1: SW_Push; SW_PUSH_6mm
R1, R2, R3, R4, R5: 470R; R_Axial_DIN0207_L6.3mm_D2.5mm_P7.62mm_Horizontal
R6, R7, R16, R18, R19, R20, R21, R24, R25: 10k; R_Axial_DIN0207_L6.3mm_D2.5mm_P7.62mm_Horizontal
R8, R9, R10, R11, R12, R13, R14, R15, R22, R23: 1k; R_Axial_DIN0207_L6.3mm_D2.5mm_P7.62mm_Horizontal
R17: 4.7k; R_Axial_DIN0207_L6.3mm_D2.5mm_P7.62mm_Horizontal
RESET1: SW_Push; SW_PUSH_6mm
SLOT0, SLOT1, SLOT2, SLOT3, SLOT4, SLOT5: Conn_01x40; PinSocket_2x25_P2.54mm_Vertical
SW2: SW_Push_DPDT; SW_E-Switch_EG1271_SPDT
U1: L7805; TO-220-3_Vertical
U2: AT22V10; DIP-24_W7.62mm_Socket
U3: W65C51NxP; DIP-28_W15.24mm_Socket
U4: HM62256BLP; DIP-28_W7.62mm_Socket
U5: 74AC161; DIP-16_W7.62mm_Socket
U6: 28C256; DIP-28_W15.24mm_Socket
U7: GAL16V8; DIP-20_W7.62mm_Socket
U8: W65C02SxP; DIP-40_W15.24mm_Socket
X1: 24MHz; Oscillator_DIP-8
X2: 1.8432MHz; Oscillator_DIP-8

Connections:
+5V: C2.2, C4.1, C5.1, C6.1, C7.2, C8.2, C9.1, C10.2, C11.1, C12.2, C13.1, C14.2, C15.2, C16.1, C17.1, C18.2, C19.2, C20.2, D3.2 (A), IC1.2 (+5V), IC2.2 (+5V), J2.4, J4.1, R6.1, R7.1, R8.1, R9.1, R10.1, R11.1, R12.1, R13.1, R14.1, R15.1, R16.2, R18.2, R22.1, R23.1, R24.1, R25.1, SLOT0.24, SLOT0.25, SLOT1.24, SLOT1.25, SLOT2.24, SLOT2.25, SLOT3.24, SLOT3.25, SLOT4.24, SLOT4.25, SLOT5.24, SLOT5.25, U1.3 (OUT), U2.24 (VCC), U3.15 (VCC), U4.28 (VCC), U5.3 (D0), U5.6 (D3), U5.7 (CEP), U5.10 (CET), U5.16 (VCC), U6.28 (VCC), U7.20 (VCC), U8.8 (VDD), X1.8 (Vcc), X2.8 (Vcc)
/CLK_24M: U5.2 (CP), X1.5 (OUT)
/DS1: J3.2, R22.2, U5.4 (D1)
/DS2: J3.4, R23.2, U5.5 (D2)
/RX: J2.3, U3.12 (RxD)
/TX: J2.2, U3.10 (TxD)
/~CTS: R19.2, U3.9 (~CTS)
/~DSR: J2.1, R21.2, U3.17 (~DSR)
/~RTS: J2.5, U3.8 (~RTS)
A0: SLOT0.1, SLOT1.1, SLOT2.1, SLOT3.1, SLOT4.1, SLOT5.1, U3.13 (RS0), U4.10 (A0), U6.10 (A0), U8.9 (A0)
A1: SLOT0.3, SLOT1.3, SLOT2.3, SLOT3.3, SLOT4.3, SLOT5.3, U3.14 (RS1), U4.9 (A1), U6.9 (A1), U8.10 (A1)
A2: SLOT0.5, SLOT1.5, SLOT2.5, SLOT3.5, SLOT4.5, SLOT5.5, U4.8 (A2), U6.8 (A2), U8.11 (A2)
A3: SLOT0.7, SLOT1.7, SLOT2.7, SLOT3.7, SLOT4.7, SLOT5.7, U4.7 (A3), U6.7 (A3), U8.12 (A3)
A4: SLOT0.9, SLOT1.9, SLOT2.9, SLOT3.9, SLOT4.9, SLOT5.9, U2.2 (I0), U4.6 (A4), U6.6 (A4), U8.13 (A4)
A5: SLOT0.11, SLOT1.11, SLOT2.11, SLOT3.11, SLOT4.11, SLOT5.11, U2.3 (I1), U4.5 (A5), U6.5 (A5), U8.14 (A5)
A6: SLOT0.13, SLOT1.13, SLOT2.13, SLOT3.13, SLOT4.13, SLOT5.13, U2.4 (I2), U4.4 (A6), U6.4 (A6), U8.15 (A6)
A7: SLOT0.15, SLOT1.15, SLOT2.15, SLOT3.15, SLOT4.15, SLOT5.15, U2.5 (I3), U4.3 (A7), U6.3 (A7), U8.16 (A7)
A8: J4.4, SLOT0.17, SLOT1.17, SLOT2.17, SLOT3.17, SLOT4.17, SLOT5.17, U2.6 (I4), U4.25 (A8), U6.25 (A8), U8.17 (A8)
A9: J4.5, SLOT0.19, SLOT1.19, SLOT2.19, SLOT3.19, SLOT4.19, SLOT5.19, U2.7 (I5), U4.24 (A9), U6.24 (A9), U8.18 (A9)
A10: J4.8, SLOT0.21, SLOT1.21, SLOT2.21, SLOT3.21, SLOT4.21, SLOT5.21, U2.8 (I6), U4.21 (A10), U6.21 (A10), U8.19 (A10)
A11: J4.6, SLOT0.27, SLOT1.27, SLOT2.27, SLOT3.27, SLOT4.27, SLOT5.27, U2.9 (I7), U4.23 (A11), U6.23 (A11), U8.20 (A11)
A12: SLOT0.29, SLOT1.29, SLOT2.29, SLOT3.29, SLOT4.29, SLOT5.29, U2.10 (I8), U4.2 (A12), U6.2 (A12), U8.22 (A12)
A13: J4.3, SLOT0.31, SLOT1.31, SLOT2.31, SLOT3.31, SLOT4.31, SLOT5.31, U2.11 (I9), U4.26 (A13), U6.26 (A13), U7.15 (IO5), U8.23 (A13)
A14: SLOT0.33, SLOT1.33, SLOT2.33, SLOT3.33, SLOT4.33, SLOT5.33, U2.13 (CLK/OD), U4.1 (A14), U6.1 (A14), U7.14 (IO6), U8.24 (A14)
A15: SLOT0.35, SLOT1.35, SLOT2.35, SLOT3.35, SLOT4.35, SLOT5.35, U2.14 (LR/O4), U7.9 (I9), U8.25 (A15)
BE: R7.2, SLOT0.39, SLOT1.39, SLOT2.39, SLOT3.39, SLOT4.39, SLOT5.39, U8.36 (BE)
CLK: SLOT0.41, SLOT1.41, SLOT2.41, SLOT3.41, SLOT4.41, SLOT5.41, U2.1 (OD/CLK), U3.27 (ϕ2), U5.12 (Q2), U7.1 (I1/CLK), U8.37 (ϕ0)
CLK_12M: SLOT0.42, SLOT1.42, SLOT2.42, SLOT3.42, SLOT4.42, SLOT5.42, U5.14 (Q0)
D0: SLOT0.2, SLOT1.2, SLOT2.2, SLOT3.2, SLOT4.2, SLOT5.2, U3.18 (D0), U4.11 (Q0), U6.11 (D0), U8.33 (D0)
D1: SLOT0.4, SLOT1.4, SLOT2.4, SLOT3.4, SLOT4.4, SLOT5.4, U3.19 (D1), U4.12 (Q1), U6.12 (D1), U8.32 (D1)
D2: SLOT0.6, SLOT1.6, SLOT2.6, SLOT3.6, SLOT4.6, SLOT5.6, U3.20 (D2), U4.13 (Q2), U6.13 (D2), U8.31 (D2)
D3: J4.14, SLOT0.8, SLOT1.8, SLOT2.8, SLOT3.8, SLOT4.8, SLOT5.8, U3.21 (D3), U4.15 (Q3), U6.15 (D3), U8.30 (D3)
D4: J4.13, SLOT0.10, SLOT1.10, SLOT2.10, SLOT3.10, SLOT4.10, SLOT5.10, U3.22 (D4), U4.16 (Q4), U6.16 (D4), U8.29 (D4)
D5: J4.12, SLOT0.12, SLOT1.12, SLOT2.12, SLOT3.12, SLOT4.12, SLOT5.12, U3.23 (D5), U4.17 (Q5), U6.17 (D5), U8.28 (D5)
D6: J4.11, SLOT0.14, SLOT1.14, SLOT2.14, SLOT3.14, SLOT4.14, SLOT5.14, U3.24 (D6), U4.18 (Q6), U6.18 (D6), U8.27 (D6)
D7: J4.10, SLOT0.16, SLOT1.16, SLOT2.16, SLOT3.16, SLOT4.16, SLOT5.16, U3.25 (D7), U4.19 (Q7), U6.19 (D7), U8.26 (D7)
EX0: SLOT0.18, SLOT1.18, SLOT2.18, SLOT3.18, SLOT4.18, SLOT5.18
EX1: SLOT0.20, SLOT1.20, SLOT2.20, SLOT3.20, SLOT4.20, SLOT5.20
EX2: SLOT0.44, SLOT1.44, SLOT2.44, SLOT3.44, SLOT4.44, SLOT5.44
EX3: SLOT0.46, SLOT1.46, SLOT2.46, SLOT3.46, SLOT4.46, SLOT5.46
GND: C1.2, C2.1, C3.2, C4.2, C5.2, C6.2, C7.1, C8.1, C9.2, C10.1, C11.2, C12.1, C13.2, C14.1, C15.1, C16.2, C17.2, C18.1, C19.1, C20.1, H1.1, H2.1, H3.1, H4.1, H5.1, IC1.3 (GND), IC2.3 (GND), J1.2, J2.6, J4.7, NMI1.1, R1.2, R2.2, R3.2, R4.2, R5.2, R19.1, R20.1, R21.1, RESET1.1, SLOT0.23, SLOT0.26, SLOT1.23, SLOT1.26, SLOT2.23, SLOT2.26, SLOT3.23, SLOT3.26, SLOT4.23, SLOT4.26, SLOT5.23, SLOT5.26, U1.2 (GND), U2.12 (GND), U3.1 (VSS), U4.14 (GND), U4.22 (~OE), U5.8 (GND), U6.14 (GND), U6.20 (~CS), U7.10 (GND), U8.21 (VSS), X1.4 (GND), X2.4 (GND)
LED1: LED1.2 (A), SLOT0.34, SLOT1.34, SLOT2.34, SLOT3.34, SLOT4.34, SLOT5.34
LED2: LED2.2 (A), SLOT0.36, SLOT1.36, SLOT2.36, SLOT3.36, SLOT4.36, SLOT5.36
LED3: LED3.2 (A), SLOT0.38, SLOT1.38, SLOT2.38, SLOT3.38, SLOT4.38, SLOT5.38
LED4: LED4.2 (A), SLOT0.40, SLOT1.40, SLOT2.40, SLOT3.40, SLOT4.40, SLOT5.40
unnamed: D1.2 (A), J1.1
unnamed: C1.1, D1.1 (K), SW2.1 (A), SW2.4 (A)
unnamed: D2.1 (K), SLOT4.22
unnamed: D3.1 (K), R5.1
unnamed: D4.1 (K), SLOT0.22
unnamed: D5.1 (K), SLOT1.22
unnamed: D6.1 (K), SLOT5.22
unnamed: D7.1 (K), SLOT2.22
unnamed: D8.1 (K), SLOT3.22
unnamed: D10.1 (K), J5.2
unnamed: IC2.1 (/RST), NMI1.2, R17.2
unnamed: LED1.1 (K), R1.1
unnamed: LED2.1 (K), R2.1
unnamed: LED3.1 (K), R3.1
unnamed: LED4.1 (K), R4.1
unnamed: C3.1, SW2.2 (B), SW2.5 (B), U1.1 (IN)
unnamed: R18.1, U3.2 (CS1)
unnamed: U3.6 (XTAL1), X2.5 (OUT)
unnamed: R20.2, U3.16 (~DCD)
unnamed: U5.9 (~PE), U5.11 (Q3)
unnamed: R24.2, U6.27 (~WE)
unnamed: R25.2, U8.38 (~SO)
RDY: R6.2, SLOT0.37, SLOT1.37, SLOT2.37, SLOT3.37, SLOT4.37, SLOT5.37, U8.2 (RDY)
R~W: SLOT0.43, SLOT1.43, SLOT2.43, SLOT3.43, SLOT4.43, SLOT5.43, U3.28 (R/~W), U7.11 (I10/~OE), U8.34 (R/~W)
SYNC: SLOT0.47, SLOT1.47, SLOT2.47, SLOT3.47, SLOT4.47, SLOT5.47, U8.7 (SYNC)
~INH: R13.2, SLOT0.30, SLOT1.30, SLOT2.30, SLOT3.30, SLOT4.30, SLOT5.30, U7.13 (IO7)
~IRQ0: R14.2, SLOT0.48, U7.2 (I2)
~IRQ1: R12.2, SLOT1.48, U7.3 (I3)
~IRQ2: R11.2, SLOT2.48, U7.4 (I4)
~IRQ3: R10.2, SLOT3.48, U7.5 (I5)
~IRQ4: R9.2, SLOT4.48, U7.6 (I6)
~IRQ5: R15.2, SLOT5.48, U7.7 (I7)
~IRQ: SLOT0.45, SLOT1.45, SLOT2.45, SLOT3.45, SLOT4.45, SLOT5.45, U7.19 (IO1), U8.4 (~IRQ)
~NMI: R17.1, SLOT0.50, SLOT1.50, SLOT2.50, SLOT3.50, SLOT4.50, SLOT5.50, U8.6 (~NMI)
~RAMW: J4.2, U4.27 (~WE), U7.16 (IO4)
~RAM_CS: J4.9, U4.20 (~CS), U7.18 (IO2)
~RESET: IC1.1 (/RST), RESET1.2, SLOT0.49, SLOT1.49, SLOT2.49, SLOT3.49, SLOT4.49, SLOT5.49, U3.4 (~RES), U5.1 (~MR), U8.40 (~RES)
~ROM_CS: D9.1 (K), U6.22 (~OE), U7.17 (I03)
~SER_IRQ: R16.1, U3.26 (~IRQ), U7.8 (I8)
~SER: J5.1, U2.15 (A0/O3), U3.3 (~CS2)
~SLOT0: SLOT0.32, U2.23 (O0/LR)
~SLOT1: SLOT1.32, U2.22 (O1/A0)
~SLOT2: SLOT2.32, U2.21 (O2/A1)
~SLOT3: SLOT3.32, U2.20 (O3/A2)
~SLOT4: SLOT4.32, U2.19 (O4/NC)
~SLOT5: SLOT5.32, U2.18 (NC/O0)
~SLOW: D2.2 (A), D4.2 (A), D5.2 (A), D6.2 (A), D7.2 (A), D8.2 (A), D9.2 (A), D10.2 (A), J3.1, J3.3, R8.2
~SSEL: SLOT0.28, SLOT1.28, SLOT2.28, SLOT3.28, SLOT4.28, SLOT5.28, U2.17 (A2/O1), U7.12 (IO8)

Notes on the sheet:
Jumper to use clock stretching for serial
Replace IRQ pull up with SLOW pullup

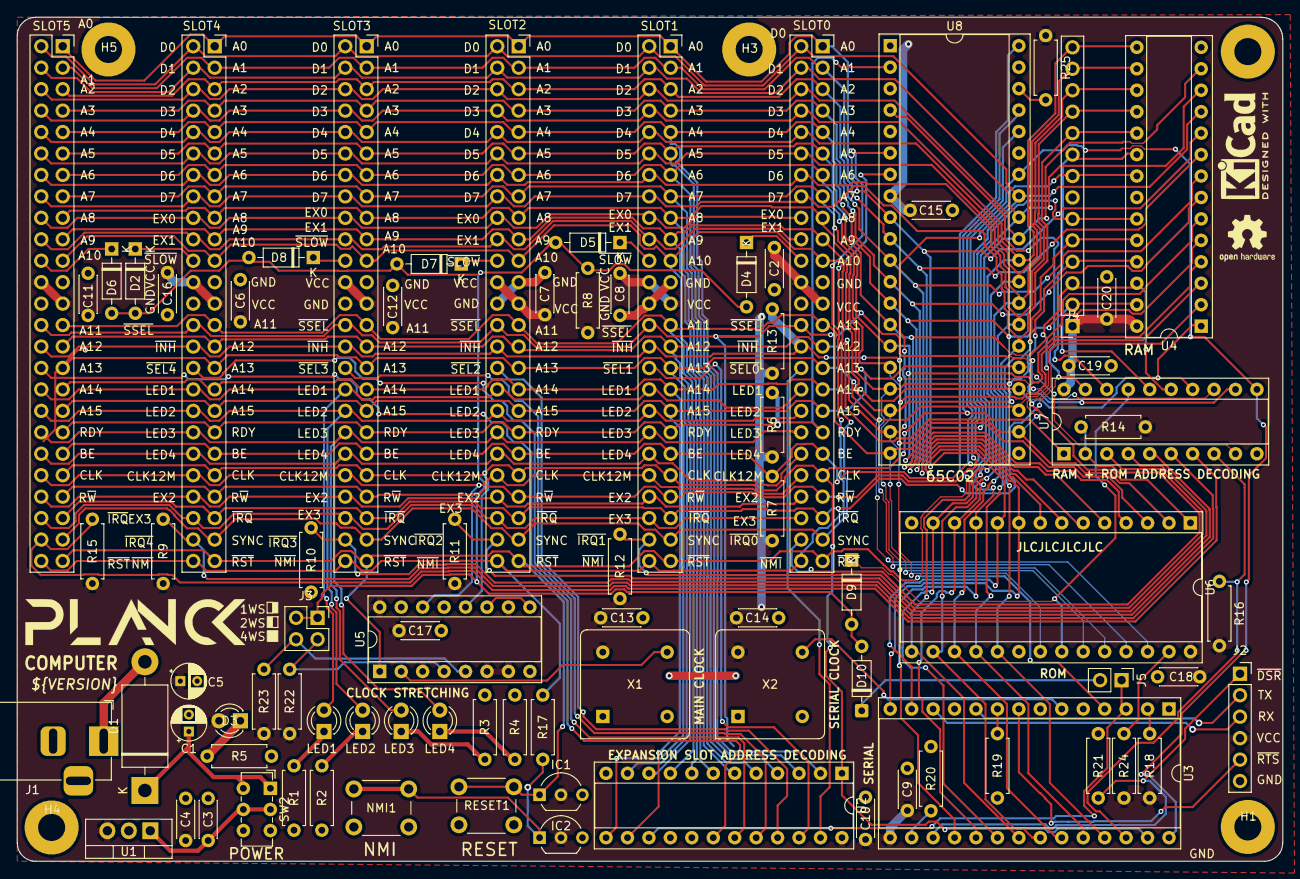
[picture p28: board mainboard.kicad_pcb from above]

Board: 2 copper layers, 149.9 x 99.9 mm, 90 parts (0 on the bottom side), 93 nets.
