lexx-polarnet-pl/planck6502/Hardware/audio_board/audio_board.kicad_pcb

## KiCad design Hardware/audio_board/audio_board.kicad_pcb (2026-10-25)

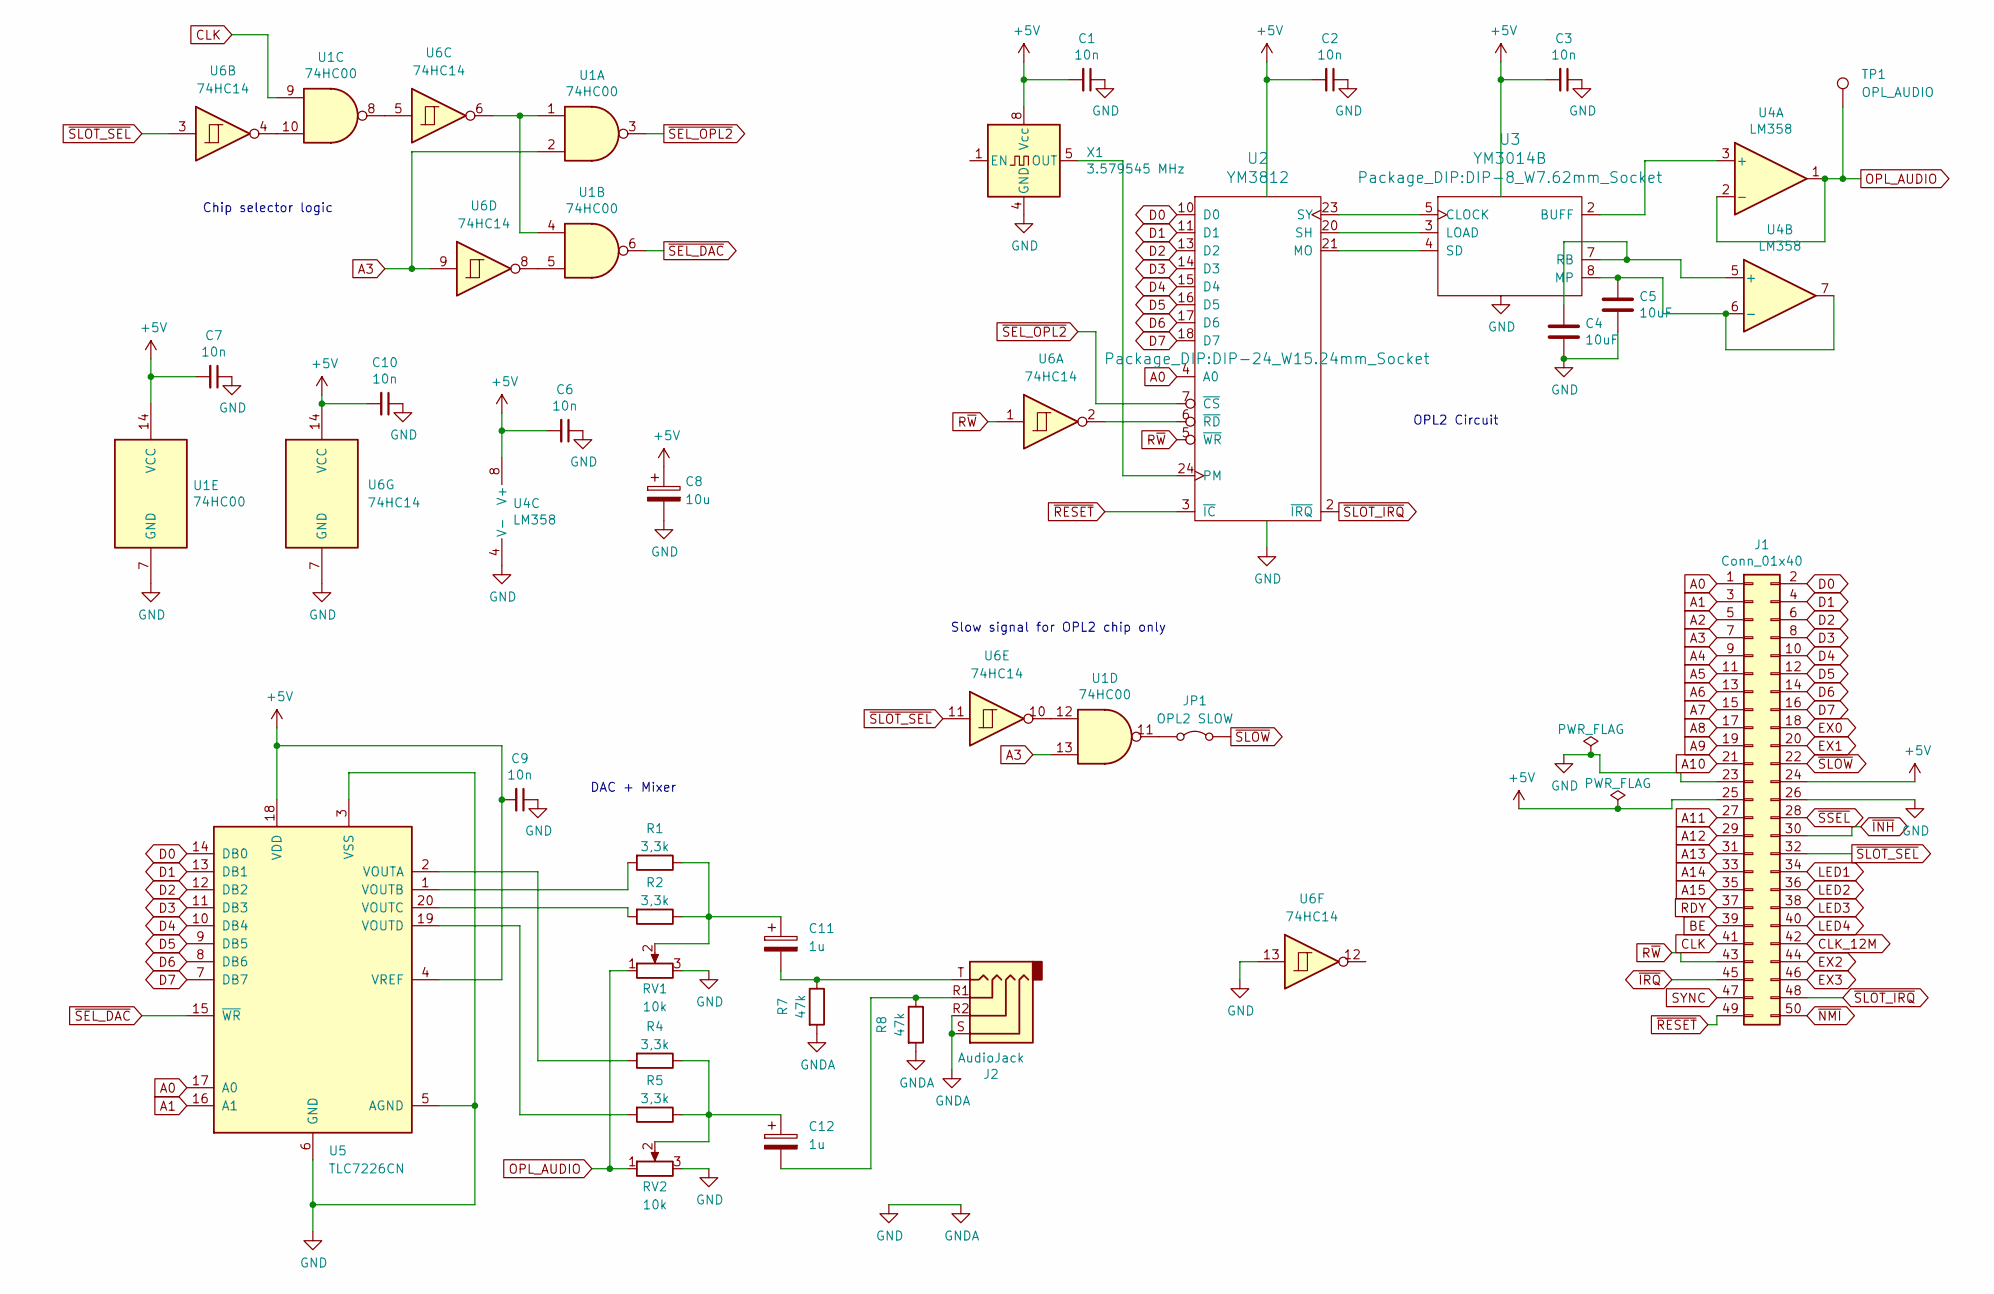
[picture p29: schematic audio_board.kicad_sch, PLANCK AUDIO BOARD]

Parts:
C1, C2, C3, C6, C7, C9, C10: 10n; C_Disc_D4.3mm_W1.9mm_P5.00mm
C4, C5: 10uF; C_Disc_D4.3mm_W1.9mm_P5.00mm
C8: 10u; CP_Radial_D5.0mm_P2.50mm
C11, C12: 1u; CP_Radial_D5.0mm_P2.50mm
J1: Conn_01x40; PinHeader_2x25_P2.54mm_Horizontal
J2: AudioJack; TRRS-PJ-320A-no-Fmask
JP1: OPL2 SLOW; TestPoint_2Pads_Pitch2.54mm_Drill0.8mm
R1, R2, R4, R5: 3,3k; R_Axial_DIN0207_L6.3mm_D2.5mm_P10.16mm_Horizontal
R7, R8: 47k; R_Axial_DIN0207_L6.3mm_D2.5mm_P10.16mm_Horizontal
RV1, RV2: 10k; Potentiometer_Runtron_RM-065_Vertical
TP1: OPL_AUDIO; Pin_D0.7mm_L6.5mm_W1.8mm_FlatFork
U1: 74HC00; DIP-14_W7.62mm_Socket
U2: YM3812; DIP-24_W15.24mm_Socket
U3: YM3014B; DIP-8_W7.62mm_Socket
U4: LM358; DIP-8_W7.62mm_Socket
U5: TLC7226CN; DIP-20_W7.62mm_Socket
U6: 74HC14; DIP-14_W7.62mm_Socket
X1: 3.579545 MHz; Oscillator_DIP-8

Connections:
+5V: C1.2, C2.2, C3.2, C6.2, C7.2, C8.1, C9.2, C10.2, J1.24, J1.25, U1.14 (VCC), U2.1 (VCC), U3.1 (VCC), U4.8 (V+), U5.4 (VREF), U5.18 (VDD), U6.14 (VCC), X1.8 (Vcc)
A0: J1.1, U2.4 (A0), U5.17 (A0)
A1: J1.3, U5.16 (A1)
A2: J1.5
A3: J1.7, U1.2, U1.13, U6.9
A4: J1.9
A5: J1.11
A6: J1.13
A7: J1.15
A8: J1.17
A9: J1.19
A10: J1.21
A11: J1.27
A12: J1.29
A13: J1.31
A14: J1.33
A15: J1.35
BE: J1.39
CLK: J1.41, U1.9
CLK_12M: J1.42
D0: J1.2, U2.10 (D0), U5.14 (DB0)
D1: J1.4, U2.11 (D1), U5.13 (DB1)
D2: J1.6, U2.13 (D2), U5.12 (DB2)
D3: J1.8, U2.14 (D3), U5.11 (DB3)
D4: J1.10, U2.15 (D4), U5.10 (DB4)
D5: J1.12, U2.16 (D5), U5.9 (DB5)
D6: J1.14, U2.17 (D6), U5.8 (DB6)
D7: J1.16, U2.18 (D7), U5.7 (DB7)
EX0: J1.18
EX1: J1.20
EX2: J1.44
EX3: J1.46
GND: C1.1, C2.1, C3.1, C4.2, C5.2, C6.1, C7.1, C8.2, C9.1, C10.1, J1.23, J1.26, J2.R2, J2.S, R7.2, R8.2, RV1.3, RV2.3, U1.7 (GND), U2.12 (GND), U3.6 (GND), U4.4 (V-), U5.3 (VSS), U5.5 (AGND), U5.6 (GND), U6.7 (GND), U6.13, X1.4 (GND)
LED1: J1.34
LED2: J1.36
LED3: J1.38
LED4: J1.40
unnamed: C11.1, R1.1, R2.1, RV1.2
unnamed: C11.2, J2.T, R7.1
unnamed: C12.1, R4.1, R5.1, RV2.2
unnamed: C12.2, J2.R1, R8.1
unnamed 41: JP1.1 (A), U1.11; also elsewhere on the board
unnamed: U1.1, U1.4, U6.6
unnamed: U1.5, U6.8
unnamed: U1.8, U6.5
unnamed: U1.10, U6.4
unnamed: U1.12, U6.10
unnamed: U2.21 (MO), U3.4 (SD)
unnamed: U2.24 (PM), X1.5 (OUT)
unnamed: U2.20 (SH), U3.3 (LOAD)
unnamed: U2.23 (SY), U3.5 (CLOCK)
unnamed: U2.6 (~RD), U6.2
unnamed: U3.2 (BUFF), U4.3 (+)
unnamed: C5.1, U3.8 (MP), U4.6 (-), U4.7
unnamed: C4.1, U3.7 (RB), U4.5 (+)
unnamed: R4.2, U5.2 (VOUTA)
unnamed: R1.2, U5.1 (VOUTB)
unnamed: R2.2, U5.20 (VOUTC)
unnamed: R5.2, U5.19 (VOUTD)
OPL_AUDIO: RV1.1, RV2.1, TP1.1 (1_1), U4.1, U4.2 (-)
RDY: J1.37
R~W: J1.43, U2.5 (~WR), U6.1
SYNC: J1.47
~INH: J1.30
~IRQ: J1.45
~NMI: J1.50
~RESET: J1.49, U2.3 (~IC)
~SEL_DAC: U1.6, U5.15 (~WR)
~SEL_OPL2: U1.3, U2.7 (~CS)
~SLOT_IRQ: J1.48, U2.2 (~IRQ)
~SLOT_SEL: J1.32, U6.3, U6.11
~SLOW: J1.22, JP1.2 (B); also elsewhere on the board
~SSEL: J1.28

Notes on the sheet:
Slow signal for OPL2 chip only
OPL2 Circuit
DAC + Mixer
Chip selector logic

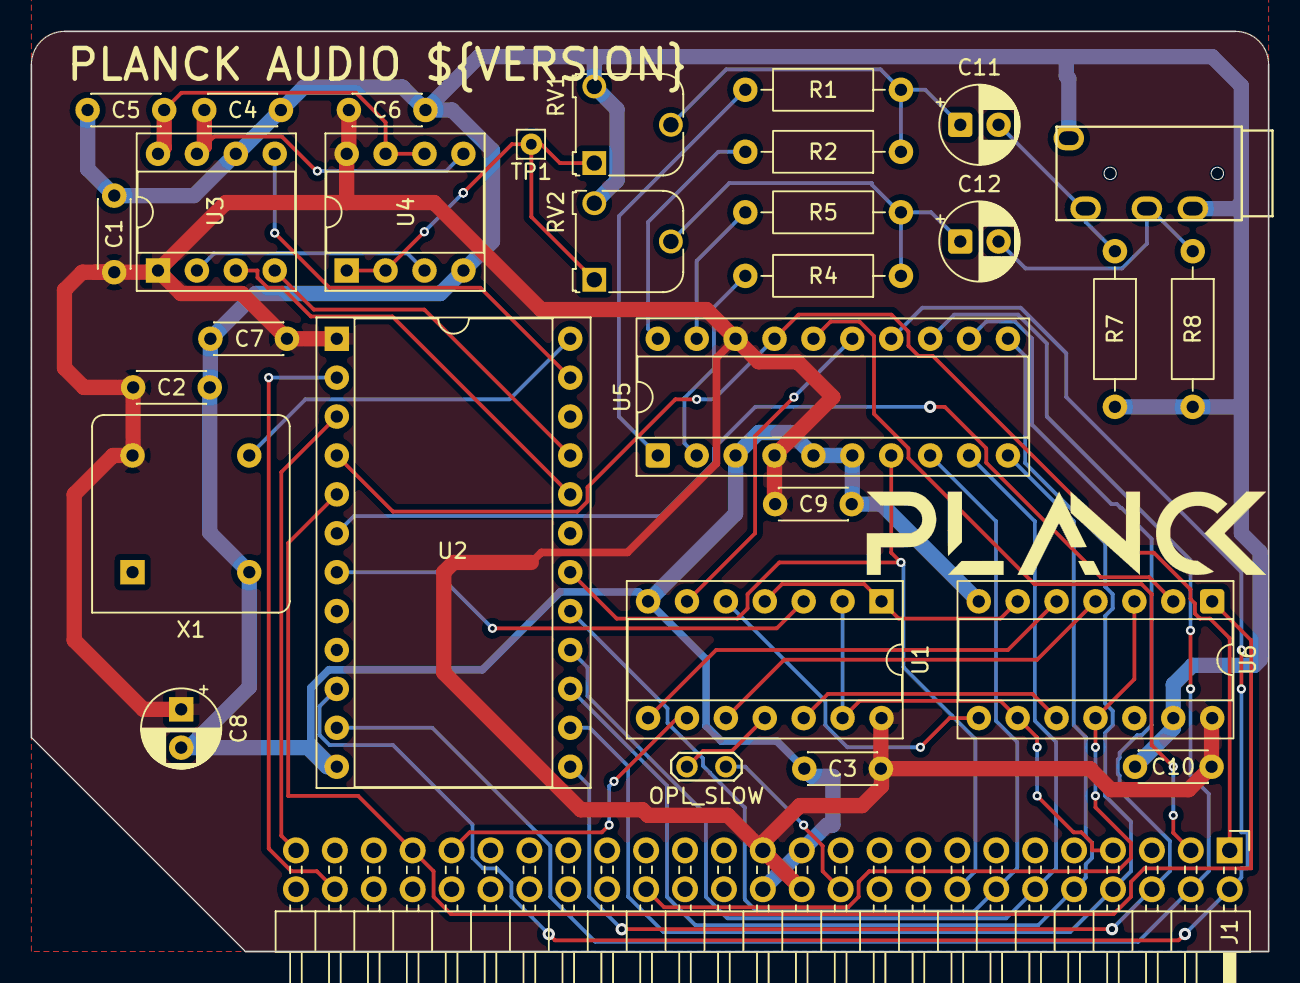
[picture p30: board audio_board.kicad_pcb from above]

Board: 2 copper layers, 80.8 x 60.1 mm, 31 parts (0 on the bottom side), 44 nets.

Other parts of the board:
OPL_SLOW: OPL2 SLOW; TestPoint_2Pads_Pitch2.54mm_Drill0.8mm

Their connections:
unnamed 41: OPL_SLOW.1 (A); also elsewhere on the board
~SLOW: OPL_SLOW.2 (B); also elsewhere on the board
