lexx-polarnet-pl/planck6502/(commit log)

2026-10-25 Ram board with AS6 chip
    [ram_board.kicad_pcb, ram_board.kicad_sch]
2026-10-25 Audio board initial commit
    [audio_board.kicad_pcb, audio_board.kicad_sch]
2026-10-25 keyboard and mouse board
    [kb_mouse.kicad_pcb, kb_mouse.kicad_sch]
2026-10-25 Added main board
    [BOM.csv, barrel_jack.step, mainboard.kicad_pcb, mainboard.kicad_sch]
2026-10-25 joystick card initial upload
    [joystick.kicad_pcb, joystick.kicad_sch]
2026-10-25 some 3d models to upload
    [cards separator.scad, cards_separator.stl]
2026-10-25 Example programs in assembly
    [planck.cfg]
2026-10-25 Lexx/Planck BIOS
    [lexx.cfg]
2026-10-26 C runtime added + sample programs
    [lexx.cfg]
2026-10-29 RDY latch fix
    [kb_mouse.kicad_pcb, kb_mouse.kicad_sch]
2026-10-29 WRITE signal now ative when writing to memmory window
    [ram_board.kicad_pcb, ram_board.kicad_sch]
2026-10-30 versions clean up for ram board
    [ram_board-B_Cu.gbr, ram_board-B_Mask.gbr, ram_board-B_Paste.gbr, ram_board-B_Silkscreen.gbr, ram_board-Edge_Cuts.gbr, ram_board-F_Cu.gbr, ram_board-F_Mask.gbr, ram_board-F_Paste.gbr]
2026-10-30 versions clean up for keyboard and mouse board
    [kb_mouse-B_Cu.gbr, kb_mouse-B_Mask.gbr, kb_mouse-B_Paste.gbr, kb_mouse-B_Silkscreen.gbr, kb_mouse-Edge_Cuts.gbr, kb_mouse-F_Cu.gbr, kb_mouse-F_Mask.gbr, kb_mouse-F_Paste.gbr]
2026-10-30 some work on joystick pcb, should have all parts now, but joystick port footprints are still to be done
    [joystick.kicad_pcb, joystick.kicad_sch]
2026-11-01 swapped cr with lf
    [vga_text_mode.c]
2026-11-01 few updates on PCB
    [kb_mouse.kicad_pcb]
2026-11-03 doc fix, all RTC vars are BCD
    [bios_utils.asm]
2026-11-03 Add random number generator, fix WRITE to card, improve write to RTC
    [main.cpp, ps2.cpp, random.cpp, rtc.cpp]
2026-11-04 short mem test added (detection of banks only)
    [bios_mem.asm]
2026-11-04 VIA baset keyboard support removed, and switched to Mega console card, interrupt driven
    [lexx.cfg]
2026-11-04 switch from keys to arrows
2026-11-07 slot re-arangement
2026-11-07 final 1.0 joystic card + gerbers
    [joystick.kicad_pcb, joystick.kicad_sch]
2026-11-07 final 1.1 keyboard/mouse card + gerbers
    [kb_mouse.kicad_pcb]
2026-11-07 final 1.1 ram board card + gerbers
    [ram_board.kicad_pcb]
2026-11-07 initial version of joystick port bracket, required for assembly
    [planck_joystick_port_bracket.scad, planck_joystick_port_bracket.stl]
2026-11-07 work on alternative firmware for pico vga card started
2026-11-09 Work stared on Pico2 graphics card
    [pico2_vga.kicad_pcb, pico2_vga.kicad_sch]
2026-11-10 Keyboard and mouse card improvements - open drain is needed for RDY signal
    [kb_mouse.kicad_pcb, kb_mouse.kicad_sch]
2026-11-10 PCB complete, circuit ready to be tested on breadboard.
    [pico2_vga.kicad_pcb]
2026-11-11 Small updates in footprints/models
    [pico2_vga.kicad_pcb, pico2_vga.kicad_sch]
2026-11-11 Joystick board render added
    [joystick.kicad_pcb]
