lexx-polarnet-pl/planck6502/(notices)

Notices in the files:
Hardware/mainboard/mainboard.kicad_pcb:
©Jonathan Foucher 2021
